KyThuatUAV/ESP32_FC/Tài liệu kèm theo/TAI_LIEU_TU_HOC.docx

KỸ THUẬT UAV

TÀI LIỆU TỰ HỌC

Phân tích hệ thống bộ điều khiển bay LacWing FC trên nền tảng ESP32

Tác giả: Nguyễn Văn Quý

Đối tượng phân tích: mã nguồn CODE_FC/LacWing_FC_level_1, bản phát hành 3f85e41

Quy mô: 1811 dòng trong 9 tệp nguồn

Trình biên dịch tham chiếu: Arduino ESP32 core 2.0.17, FQBN esp32:esp32:esp32da

Giấy phép: GNU General Public License phiên bản 3

Tháng 9 năm 2026

MỤC LỤC

# Danh mục mã nguồn

# Danh mục từ viết tắt

Viết tắt | Nguyên nghĩa | Diễn giải
DCM | Direction Cosine Matrix | ma trận cosin chỉ phương
DLPF | Digital Low-Pass Filter | bộ lọc thông thấp số bên trong cảm biến
ESC | Electronic Speed Controller | bộ điều tốc động cơ
FPU | Floating-Point Unit | khối tính số thực phần cứng
I²C | Inter-Integrated Circuit | bus nối tiếp hai dây
IIR | Infinite Impulse Response | bộ lọc đáp ứng xung vô hạn
IMU | Inertial Measurement Unit | cảm biến quán tính
ISA | International Standard Atmosphere | khí quyển tiêu chuẩn quốc tế
KF | Kalman Filter | bộ lọc Kalman
LEDC | LED Control | ngoại vi phát xung PWM của ESP32
LSB | Least Significant Bit | bước lượng tử nhỏ nhất của bộ biến đổi
ODR | Output Data Rate | tần số xuất dữ liệu của cảm biến
OSR | Oversampling Ratio | bội số lấy mẫu
PID | Proportional–Integral–Derivative | khối điều khiển tỉ lệ – tích phân – vi phân
PWM | Pulse-Width Modulation | điều chế độ rộng xung
QNH | — | áp suất khí quyển quy về mực nước biển
RC | Radio Control | điều khiển vô tuyến
RTOS | Real-Time Operating System | hệ điều hành thời gian thực
SBUS | Serial Bus | giao thức nối tiếp giữa bộ thu và bộ điều khiển bay
SMP | Symmetric Multiprocessing | đa xử lý đối xứng
SoC | System on Chip | hệ thống trên một chip
SPI | Serial Peripheral Interface | bus nối tiếp đồng bộ bốn dây
UART | Universal Asynchronous Receiver–Transmitter | cổng nối tiếp không đồng bộ

# Mở đầu: phạm vi, giả thiết và quy ước

## 0.1 Phạm vi

Tài liệu phân tích cấu trúc và đặc tính định lượng của phần mềm điều khiển bay cho phương tiện bay không người lái bốn cánh quạt cấu hình chữ X. Phân tích giới hạn ở lớp phần mềm nhúng; các vấn đề khí động lực học, mô hình hoá lực đẩy và nhận dạng tham số khung máy nằm ngoài phạm vi.

Đối tượng gồm chín tệp nguồn: tám tệp .ino, được trình dựng Arduino ghép thành một đơn vị biên dịch duy nhất, và một tệp tiêu đề types.h. Mỗi luận điểm trong tài liệu được gắn với đoạn mã hiện thực nó. Các đoạn mã then chốt được trích nguyên văn và phân tích theo từng dòng, để người đọc kiểm chứng trực tiếp trên mã nguồn thay vì tiếp nhận kết luận một cách thụ động.

## 0.2 Giả thiết

- G1. Cảm biến quán tính gắn cứng vào khung, trục cảm biến trùng trục thân máy, sai lệch lắp đặt được xem là nhỏ và đã bù bằng hằng số tĩnh.
- G2. Góc nghiêng vận hành nhỏ, cho phép xấp xỉ tuyến tính hoá quanh trạng thái treo.
- G3. Bốn cơ cấu chấp hành đồng nhất về đặc tính lực đẩy theo tín hiệu điều khiển; hệ không bù phi tuyến lực đẩy và không bù sụt áp nguồn.
- G4. Nhiễu đo của gia tốc kế và áp kế được mô hình hoá là nhiễu trắng Gauss không tương quan, kỳ vọng bằng không.

Giả thiết G4 bị vi phạm trong thực tế: nhiễu rung do cánh quạt là nhiễu có màu, tập trung phổ quanh tần số quay. Hệ quả được thảo luận ở §9.2.

## 0.3 Quy ước ký hiệu

Ký hiệu | Ý nghĩa | Đơn vị
Tₛ | chu kỳ lấy mẫu vòng điều khiển | s
φ, θ | góc nghiêng trục dọc (roll), trục ngang (pitch) | độ
p, q, r | vận tốc góc thân máy quanh ba trục | độ/s
a_x, a_y, a_z | gia tốc đo trong hệ thân máy | g
a_z^(E) | gia tốc thẳng đứng trong hệ mặt đất, đã trừ trọng trường | g
z, ż | độ cao và vận tốc thẳng đứng | cm, cm/s
(·)^(sp) | giá trị mong muốn (setpoint) | theo đại lượng
e, e0 | sai số của chu kỳ này và của chu kỳ liền trước | theo tầng
kp, ki, kd | hệ số khâu tỉ lệ, tích phân, vi phân | theo tầng
P_angle_roll, P_angle_pitch | đầu ra Tầng 2 (góc) — khối P | độ/s
PID_roll, PID_pitch, PID_yaw | đầu ra Tầng 1 (vận tốc góc) — khối PID | đơn vị đếm PWM
PID_vel_z | đầu ra Tầng 1 của trục thẳng đứng (vận tốc thẳng đứng) | đơn vị đếm PWM
throttle | ga lấy từ tay điều khiển | đơn vị đếm PWM

Đầu ra của mỗi khối điều khiển được đặt tên theo loại khối, không theo một tên chung cho mọi tín hiệu điều khiển: khối chỉ có khâu tỉ lệ cho đầu ra P_<tầng>, khối tỉ lệ – tích phân cho PI_<tầng>, khối đủ ba khâu cho PID_<tầng>. Riêng tầng vận tốc góc ghi theo trục (PID_roll, PID_pitch, PID_yaw) để khớp trực tiếp với công thức phân phối động cơ ở §5.5.

Các tầng được đánh số từ vòng trong ra ngoài: với hai trục nghiêng, vận tốc góc là Tầng 1 và góc là Tầng 2; với trục thẳng đứng, vận tốc thẳng đứng là Tầng 1. Nhờ đó tên gọi phản ánh cấu trúc: đọc tên là biết khối loại gì và nối vào tầng nào.

Quy ước đặt tên trong mã nguồn mang đơn vị ngay trong định danh (_deg, _dps, _cm, _cms, _g), nhằm loại trừ nhóm lỗi sai đơn vị tại các điểm ghép nối giữa mô-đun. Điểm ghép nối áp kế – bộ lọc Kalman (mét sang xen-ti-mét) là ví dụ điển hình cho lớp lỗi này, và được phân tích cụ thể ở Mã nguồn 4.5.

## 0.4 Đối chiếu ký hiệu với mã nguồn

Mã nguồn bản phát hành đặt đầu ra bộ điều khiển là u_*, và dùng tiền tố tilt, climb cho tầng góc và tầng vận tốc thẳng đứng. Bảng dưới cho phép đọc song song tài liệu và mã nguồn.

Ký hiệu trong tài liệu | Định danh trong mã nguồn | Tệp
PID_roll, PID_pitch, PID_yaw | u_roll, u_pitch, u_yaw | control_task.ino
P_angle_roll, P_angle_pitch | giá trị trả về của pid_tilt_roll(), pid_tilt_pitch() | pid.ino
PID_vel_z | giá trị trả về của pid_climb() | pid.ino
throttle | u_throttle ở chế độ ANGLE | control_task.ino
e, e0, I | error, st.prev_error, st.integral | pid.ino
kp_rate_roll, ki_rate_roll, kd_rate_roll | KP_RATE_ROLL, KI_RATE_ROLL, KD_RATE_ROLL | khối cấu hình
I_max, out_max | I_LIM_*, U_LIM_* | khối cấu hình

## 0.5 Quy ước trình bày mã nguồn

Mọi đoạn mã được trích nguyên văn từ bản phát hành 3f85e41, giữ nguyên chú thích gốc. Cột bên trái là số dòng trong tệp nguồn; ký hiệu ⋮ đánh dấu phần lược bỏ. Mỗi đoạn mã mang số hiệu Mã nguồn X.Y theo chương, được liệt kê ở Danh mục mã nguồn, và phần phân tích ngay sau đó dẫn chiếu theo số dòng.

Khi mã nguồn được sửa đổi về sau, số dòng có thể lệch; nội dung phân tích vẫn giữ nguyên giá trị đối với phần mã tương ứng.

# Chương 1. Kiến trúc phần mềm thời gian thực

## 1.1 Phân rã tác vụ

Hệ thống được phân rã thành ba tác vụ FreeRTOS chạy trên hai nhân xử lý của SoC ESP32:

Tác vụ | Nhân | Chu kỳ | Ưu tiên | Kích thước ngăn xếp
control_task | 1 | 2 ms (500 Hz) | 5 | 8192 B
rc_task | 0 | 2 ms (500 Hz) | 4 | 3072 B
baro_task | 0 | 10 ms (100 Hz) | 2 | 4096 B

Nhân 1 được dành riêng cho vòng điều khiển. Quyết định này loại bỏ hoàn toàn tranh chấp CPU giữa vòng điều khiển và các tác vụ ngoại vi, đổi lấy việc không tận dụng hết năng lực tính toán của nhân đó. Với hệ có ràng buộc thời gian cứng, đây là đánh đổi hợp lý: độ tin cậy về định thời quan trọng hơn hiệu suất sử dụng tài nguyên.

Trình tự dựng hệ đa tác vụ nằm ở cuối hàm setup():

Mã nguồn 1.1 — Tạo cơ chế đồng bộ và ba tác vụ (LacWing_FC_level_1.ino, dòng 204–217)

204 │ mtx_rc = xSemaphoreCreateMutex();

205 │ mtx_baro = xSemaphoreCreateMutex();

206 │ mtx_tlm = xSemaphoreCreateMutex();

207 │

208 │ if (mtx_rc == NULL || mtx_baro == NULL || mtx_tlm == NULL) {

209 │ Serial.println("Loi: khong tao duoc Mutex!");

210 │ while (1) delay(1000);

211 │ }

212 │

213 │ xTaskCreatePinnedToCore(rc_task, "RC", 3072, NULL, 4, NULL, 0);

214 │ xTaskCreatePinnedToCore(baro_task, "BARO", 4096, NULL, 2, NULL, 0);

215 │ xTaskCreatePinnedToCore(control_task, "CTRL", 8192, NULL, 5, NULL, 1);

216 │

217 │ vTaskDelete(NULL); // xoá loopTask của Arduino, giải phóng stack của nó

Phân tích.

- Dòng 204–211. Ba mutex được tạo và kiểm tra trước khi bất kỳ tác vụ nào tồn tại. Trình tự này là điều kiện cần: một tác vụ chạy trước khi mutex được tạo sẽ gọi xSemaphoreTake() trên một con trỏ rỗng. Giá trị NULL chỉ xuất hiện khi vùng nhớ động cạn; hệ dừng lại thay vì tiếp tục với một cơ chế đồng bộ khiếm khuyết.
- Dòng 213–215. xTaskCreatePinnedToCore() ghim mỗi tác vụ vào một nhân cố định, xác định bởi tham số cuối. Bộ lập lịch SMP của ESP-IDF vì thế không di trú tác vụ giữa hai nhân, loại bỏ một nguồn biến thiên định thời. Trên ESP-IDF [4], tham số kích thước ngăn xếp tính bằng byte, khác FreeRTOS gốc tính bằng từ máy — nhầm lẫn giữa hai quy ước là nguồn tràn ngăn xếp phổ biến khi chuyển mã giữa hai nền tảng.
- Thứ tự thực thi thực tế. Hàm setup() chạy bên trong tác vụ loopTask của khung Arduino, ghim ở nhân 1 với ưu tiên 1. Ngay khi control_task (ưu tiên 5, cùng nhân 1) được tạo ở dòng 215, nó chiếm quyền nhân; dòng 217 chỉ được thực thi khi control_task nhả CPU lần đầu tại vTaskDelayUntil(). Nói cách khác, chu kỳ điều khiển đầu tiên bắt đầu trước khi setup() kết thúc — hợp lệ, vì mọi khởi tạo cảm biến và bộ lọc đã hoàn tất ở các dòng phía trên.
- Dòng 217. vTaskDelete(NULL) huỷ chính loopTask; ngăn xếp của nó được tác vụ nhàn rỗi thu hồi. Hàm loop() vì thế không bao giờ được gọi.

## 1.2 Cơ chế giữ nhịp

Cả ba tác vụ dùng vTaskDelayUntil() thay vì vTaskDelay(). Khác biệt có ý nghĩa: vTaskDelayUntil() tính thời điểm đánh thức từ mốc tuyệt đối của lần trước, nên sai số thực thi của một chu kỳ không tích luỹ sang chu kỳ sau. Với vTaskDelay(), chu kỳ thực tế sẽ là Tₛ + δᵢ với δᵢ là thời gian thực thi thân vòng lặp, và sai số cộng dồn không giới hạn.

Mã nguồn 1.2 — Khung giữ nhịp của vòng điều khiển (control_task.ino, dòng 69–75 và 166–169)

69 │ void control_task(void *parameter) {

70 │ TickType_t wake = xTaskGetTickCount();

71 │ for (;;) {

72 │ static uint32_t t_prev_us = 0;

73 │ uint32_t t_now_us = micros();

74 │ loop_period_us = t_now_us - t_prev_us;

75 │ t_prev_us = t_now_us;

⋮

166 │ telemetry_snapshot();

167 │ vTaskDelayUntil(&wake, pdMS_TO_TICKS(PERIOD_CTRL_MS));

168 │ }

169 │ }

Phân tích.

- Dòng 70 và 167. Mốc wake được lấy một lần trước vòng lặp. Mỗi lần gọi ở dòng 167, hệ điều hành cộng đúng một chu kỳ vào mốc rồi cho tác vụ ngủ tới thời điểm đó. Chu kỳ danh định vì thế không phụ thuộc thời gian thực thi thân vòng. Nếu thân vòng lỡ vượt quá 2 ms, mốc mới đã nằm trong quá khứ, hàm trả về ngay và hệ chạy bù cho tới khi đuổi kịp lịch — không có chu kỳ nào bị "mất" khỏi thang thời gian tuyệt đối.
- Tiền đề ngoài mã nguồn. pdMS_TO_TICKS(2) bằng 2 tick nhờ tần số tick 1000 Hz của cấu hình Arduino-ESP32. Hệ quả: chu kỳ là bội nguyên của 1 ms. Nếu tần số tick là 100 Hz, macro trả về 0, vòng lặp chạy không giới hạn nhịp, và giả định Tₛ = DT_CTRL = 0,002 s — nền tảng của mọi phép tích phân và vi phân trong hệ — trở thành sai. Tính đúng của toàn bộ luật điều khiển phụ thuộc vào một tham số cấu hình của hệ điều hành nằm ngoài mã nguồn.
- Dòng 72–75. Chu kỳ thực được đo bằng micros(). Phép trừ trên kiểu uint32_t cho kết quả đúng cả khi bộ đếm tràn (sau khoảng 71,6 phút), nhờ số học đồng dư. Riêng lần lặp đầu tiên, mốc trước bằng 0 nên giá trị đo vô nghĩa — không ảnh hưởng điều khiển, vì biến này chỉ phục vụ quan sát qua cờ DEBUG_LOOP_TIME, với giá trị kỳ vọng 2000 µs.

## 1.3 Mô hình đồng bộ hoá và nhất quán dữ liệu

Dữ liệu chia sẻ giữa các tác vụ được bảo vệ bằng ba mutex độc lập, phân theo nhóm dữ liệu chứ không dùng một khoá toàn cục:

Mutex | Bảo vệ | Chiều ghi → đọc
mtx_rc | shared_rc_ch[17], shared_rc_ok | rc_task → control_task
mtx_baro | shared_baro_alt_m | baro_task → control_task
mtx_tlm | khối tlm_* | control_task → baro_task

Việc tách khoá theo nhóm loại bỏ phụ thuộc giả (false dependency) giữa các luồng dữ liệu không liên quan: tác vụ áp kế và tác vụ RC không bao giờ chặn lẫn nhau.

Chính sách lấy khoá. Mọi lời gọi xSemaphoreTake() đều dùng thời gian chờ bằng không. Nếu không lấy được khoá, tác vụ không chờ mà tiếp tục với dữ liệu của chu kỳ trước. Đây là quyết định thiết kế có chủ đích: vòng điều khiển không bao giờ được phép bị chặn. Cái giá là dữ liệu có thể cũ, nhưng độ cũ bị chặn trên bởi đúng một chu kỳ ghi (2 ms với RC, 10 ms với áp kế) — nhỏ hơn nhiều so với hằng số thời gian của mọi vòng điều khiển trong hệ.

Mô hình đệm kép. Tác vụ ghi chép dữ liệu vào vùng shared_* dưới khoá; tác vụ đọc sao chép sang biến cục bộ cũng dưới khoá, rồi thao tác trên bản sao. Nhờ đó mỗi chu kỳ điều khiển làm việc trên một ảnh chụp nhất quán về thời gian, thay vì đọc từng trường rời rạc có thể thuộc hai thời điểm khác nhau. Hai phía của kênh dữ liệu RC minh hoạ mô hình này.

Mã nguồn 1.3 — Phía ghi: tác vụ giải mã tay điều khiển (LacWing_FC_level_1.ino, dòng 228–240)

228 │ void rc_task(void *parameter) {

229 │ TickType_t wake = xTaskGetTickCount();

230 │ for (;;) {

231 │ bool ok = rc_update();

232 │

233 │ if (xSemaphoreTake(mtx_rc, 0) == pdTRUE) {

234 │ shared_rc_ok = ok;

235 │ for (int i = 1; i <= 16; i++) shared_rc_ch[i] = rc_get_channel(i);

236 │ xSemaphoreGive(mtx_rc);

237 │ }

238 │ vTaskDelayUntil(&wake, pdMS_TO_TICKS(PERIOD_RC_MS));

239 │ }

240 │ }

Mã nguồn 1.4 — Phía đọc: vòng điều khiển lấy dữ liệu tay điều khiển (control_task.ino, dòng 222–228)

222 │ void rc_fetch_and_map() {

223 │ if (xSemaphoreTake(mtx_rc, 0) == pdTRUE) {

224 │ rc_ok = shared_rc_ok;

225 │ for (int i = 1; i <= 16; i++) rc_ch[i] = shared_rc_ch[i];

226 │ xSemaphoreGive(mtx_rc);

227 │ }

228 │ for (int i = 5; i <= 8; i++) rc_ch[i] = rc_switch_position(rc_ch[i]);

Phân tích.

- Mã nguồn 1.3, dòng 231. Việc giải mã khung SBUS (§7.2) nằm ngoài vùng khoá. Vùng găng ở dòng 233–237 chỉ gồm việc sao chép mười sáu số nguyên và một cờ, nên thời gian giữ khoá vào cỡ micro giây, tối thiểu hoá xác suất tranh chấp.
- Mã nguồn 1.4, dòng 223–227. Phía đọc dùng cùng khuôn mẫu. rc_ok và mảng kênh được sao chép trong cùng một vùng khoá, nên không bao giờ xảy ra trạng thái lai "cờ của khung mới, kênh của khung cũ". Khi không lấy được khoá, cả hai cùng giữ giá trị cũ — cũ, nhưng vẫn nhất quán với nhau.
- Không có đảo ưu tiên. Hiện tượng đảo ưu tiên chỉ phát sinh khi tác vụ ưu tiên cao phải chờ tài nguyên do tác vụ ưu tiên thấp giữ. Thời gian chờ bằng không loại bỏ chính tiền đề đó; cơ chế thừa kế ưu tiên của mutex FreeRTOS vì vậy không bao giờ cần kích hoạt.
- Mã nguồn 1.4, dòng 228 — khiếm khuyết. Hàm rc_switch_position() biến đổi tại chỗ các kênh 5–8 từ độ rộng xung (1000–2000) sang số nấc công tắc (0, 1, 2), và được gọi vô điều kiện — kể cả khi dòng 223 không lấy được khoá. Trong trường hợp đó, rc_ch[5..8] vẫn chứa số nấc của chu kỳ trước và bị ánh xạ lần thứ hai. Vì các giá trị 0, 1, 2 không thuộc dải nào của hàm ánh xạ (control_task.ino, dòng 216–219), kết quả luôn là 0.

Hệ quả với công tắc arm đang ở nấc 2: một lần tranh chấp khoá làm rc_ch[CH_ARM] mang giá trị 0; điều kiện ở dòng 108 (Mã nguồn 8.1) lập tức đặt armed = false, và dòng 163 ghi đè bốn đầu ra bằng ESC_IDLE — động cơ ngừng khi đang bay. Chu kỳ kế tiếp, dù đọc lại được nấc 2, cũng không arm lại được, vì điều kiện arm đòi cần ga ở đáy. Kênh chế độ chịu cùng hiệu ứng: nấc 2 (ALT HOLD) bị đọc thành nấc 0 (ANGLE) trong một chu kỳ.

Hai tác vụ cùng thức theo lưới tick 1 ms, nên độ lệch pha giữa chúng được xác lập từ lúc khởi động. Khi hai tác vụ cùng pha, xác suất tranh chấp ở mỗi chu kỳ nhỏ nhưng khác không; với 500 lần thử mỗi giây và hệ quả là mất động lực trên không, khiếm khuyết không thể được biện minh bằng xác suất thấp.

Về bản chất, đây là lỗi thuộc lớp phép biến đổi không lũy đẳng áp lên trạng thái được giữ lại: f(f(x)) ≠ f(x). Nhánh "giữ giá trị cũ" của chính sách không chờ chỉ an toàn khi mọi xử lý phía sau là lũy đẳng trên dữ liệu cũ. Cách khắc phục: chỉ ánh xạ khi vừa sao chép dữ liệu mới — đưa dòng 228 vào trong khối điều kiện của dòng 223 — hoặc ánh xạ sang một mảng riêng thay vì ghi đè tại chỗ. Khiếm khuyết được ghi nhận là L9 ở Chương 10.

Khối telemetry đi theo chiều ngược lại và áp dụng cùng nguyên tắc: vòng điều khiển chỉ chụp trạng thái vào tlm_*; toàn bộ chi phí định dạng và truyền chuỗi do baro_task ở nhân 0 gánh. Không có lệnh xuất Serial nào nằm trong đường điều khiển. Đây là ràng buộc kiến trúc, không phải quy ước phong cách: ở 500 Hz, một lời gọi Serial.print() bị chặn do đầy bộ đệm truyền sẽ kéo dài chu kỳ và làm sai lệch mọi phép tích phân, vi phân dùng Tₛ hằng số.

## 1.4 Phân tích khả thi lịch biểu

Xét nhân 0 mang hai tác vụ. Đặt Cᵢ là thời gian thực thi xấu nhất, Tᵢ là chu kỳ. Tiêu chuẩn Liu–Layland [6] cho lịch biểu ưu tiên đơn điệu theo tần số với n tác vụ:

U = Σ_i=1^(n) Cᵢ/Tᵢ ≤ n(2^(1/n) - 1)

Với n = 2, ngưỡng là 0,828. Ước lượng thành phần:

- rc_task: đọc bộ đệm UART và giải mã tối đa 25 byte, C ≲ 60 µs trên T = 2 ms, đóng góp U ≈ 0,030.
- baro_task: một giao dịch I²C 7 byte ở 400 kHz chiếm khoảng 175 µs kể cả điều kiện khởi động và địa chỉ; cộng phần bù nhiệt – áp dùng số thực độ chính xác kép, ước tính C ≲ 400 µs trên T = 10 ms, đóng góp U ≈ 0,040.

Tổng U ≈ 0,07, thấp hơn ngưỡng một bậc độ lớn. Nhân 0 còn dư năng lực đáng kể; đây là chỗ có thể tiếp nhận thêm cảm biến mà không cần tái thiết kế.

Nhân 1 chỉ có một tác vụ nên điều kiện khả thi rút gọn thành C ≤ T. Ước lượng thành phần chi phối ở §9.1.

# Chương 2. Phân hệ cảm biến quán tính

## 2.1 Giao tiếp và cấu hình

Cảm biến ICM-20602 giao tiếp qua SPI ở 10 MHz, chế độ 0, truy cập trực tiếp thanh ghi. Không sử dụng thư viện trung gian. Quyết định này loại bỏ phụ thuộc phiên bản thư viện và cho phép kiểm soát chính xác trình tự khởi tạo, nhưng chuyển gánh nặng đúng đắn sang người viết.

Thanh ghi | Giá trị | Ý nghĩa
PWR_MGMT_1 (0x6B) | 0x00 | thoát chế độ ngủ
ACCEL_CONFIG (0x1C) | 0x18 | thang đo gia tốc ±16 g
GYRO_CONFIG (0x1B) | 0x18 | thang đo con quay ±2000 °/s
CONFIG (0x1A) | 0x06 | DLPF con quay: dải thông 3 dB 5 Hz, dải thông nhiễu 8 Hz, xuất dữ liệu 1 kHz
ACCEL_CONFIG2 (0x1D) | 0x05 | DLPF gia tốc kế: dải thông 3 dB 10,2 Hz, xuất dữ liệu 1 kHz

Các giá trị dải thông lấy theo bảng cấu hình bộ lọc trong datasheet ICM-20602 [1], mục 9.16 và 9.19. Cần lưu ý rằng ở cả hai cấu hình, cảm biến chỉ cập nhật thanh ghi dữ liệu 1000 lần mỗi giây; con số này chi phối cách hiểu thuật toán hiệu chỉnh ở §2.3.

Tính hiện diện của cảm biến được kiểm chứng qua thanh ghi WHO_AM_I (0x75) với giá trị kỳ vọng 0x12, trước khi thực hiện hiệu chỉnh. Trình tự này là bắt buộc: nếu cảm biến không phản hồi, bus SPI trả về giá trị hằng, hai lô mẫu liên tiếp trong vòng hiệu chỉnh sẽ giống hệt nhau, và điều kiện hội tụ được thoả mãn một cách sai lầm với độ lệch vô nghĩa. Khi không phát hiện được cảm biến, hệ thống dừng vô hạn và nhấp nháy đèn báo thay vì tiếp tục khởi động.

Toàn bộ số liệu quán tính đi qua hai hàm đọc gộp có cấu trúc giống hệt nhau; hàm đọc gia tốc được trích dưới đây.

Mã nguồn 2.1 — Đọc gộp ba trục gia tốc qua SPI (imu_icm20602.ino, dòng 300–309)

300 │ void imu_read_accel_raw(int16_t &x, int16_t &y, int16_t &z) {

301 │ digitalWrite(PIN_IMU_CS, LOW);

302 │ SPI.beginTransaction(imu_spi);

303 │ SPI.transfer(REG_ACCEL_XOUT_H | 0x80);

304 │ x = (SPI.transfer(0x00) << 8) | SPI.transfer(0x00);

305 │ y = (SPI.transfer(0x00) << 8) | SPI.transfer(0x00);

306 │ z = (SPI.transfer(0x00) << 8) | SPI.transfer(0x00);

307 │ SPI.endTransaction();

308 │ digitalWrite(PIN_IMU_CS, HIGH);

309 │ }

Phân tích.

- Dòng 301–302 và 307–308. Khung giao dịch: hạ chân chọn chip, mở giao dịch với cấu hình riêng của cảm biến (10 MHz, chế độ 0), rồi đóng theo thứ tự ngược lại. beginTransaction() đồng thời khoá bus, để không tác vụ nào chen vào giữa một giao dịch.
- Dòng 303. Bit 7 của byte địa chỉ bằng 1 báo phép đọc. Sau byte địa chỉ, ICM-20602 tự tăng địa chỉ thanh ghi, nên sáu byte liên tiếp ở dòng 304–306 là X, Y, Z của gia tốc. Đọc gộp trong một giao dịch bảo đảm ba trục thuộc cùng một thời điểm lấy mẫu.
- Dòng 304–306, thứ tự đánh giá. Mỗi trục là số bù hai 16 bit, byte cao trước. Biểu thức (SPI.transfer(0x00) << 8) | SPI.transfer(0x00) ghép byte cao với byte thấp. Theo chuẩn C++ [7], hai toán hạng của phép | không được sắp thứ tự với nhau: hai lời gọi hàm chỉ được bảo đảm không đan xen, còn lời gọi nào chạy trước là không xác định (unspecified). Mã chạy đúng vì trình biên dịch GCC của nền tảng đánh giá toán hạng trái trước — điều mà việc bay được đã gián tiếp xác nhận — nhưng tính đúng không được ngôn ngữ bảo đảm. Một trình biên dịch khác, hoặc một mức tối ưu khác, có quyền đảo hai byte mà không phát sinh cảnh báo nào. Cách viết an toàn là đọc hai byte vào hai biến tạm theo thứ tự tường minh rồi mới ghép. Ghi nhận là L11.
- Dòng 304–306, chuyển kiểu. Kết quả phép | là số nguyên không âm trong khoảng 0–65535. Gán giá trị lớn hơn 32767 vào int16_t là chuyển đổi do cài đặt quy định trước C++20 (GCC định nghĩa theo đồng dư 2^(16)), và được chuẩn hoá thành đồng dư từ C++20. Nhờ đó giá trị bù hai được khôi phục đúng.

## 2.2 Lượng tử hoá

Bộ biến đổi 16 bit trên hai thang đo đã chọn cho độ phân giải:

Δ_ω = 1/(16,4) ≈ 6,10 × 10⁻² °/s, Δₐ = 1/2048 ≈ 4,88 × 10⁻⁴ g

Sai số lượng tử hoá gia tốc kế truyền sang góc suy ra từ gia tốc. Tuyến tính hoá quanh trạng thái nằm ngang, với φ = arctan(a_y/√(a_x²+a_z²)):

(∂ φ)/(∂ a_y)|_φ=0 = 1 rad/g ⟹ δφ ≈ Δₐ · 180/π ≈ 0,028°

Độ phân giải góc do lượng tử hoá là 0,028°, nhỏ hơn hai bậc so với nhiễu rung cơ khí trong điều kiện bay thực. Kết luận: lượng tử hoá không phải là nguồn sai số chi phối; việc chọn thang đo rộng (±16 g, ±2000 °/s) để tránh bão hoà là đánh đổi đúng.

## 2.3 Hiệu chỉnh độ lệch con quay

Thuật toán hiệu chỉnh không lấy trung bình một lô cố định rồi chấp nhận kết quả. Thay vào đó nó lặp cho tới khi phát hiện phương tiện thực sự đứng yên:

Lô thứ k: Sₖ = Σ_i=1^(N) ωᵢ, N = 500

Điều kiện dừng, áp đồng thời cho ba trục:

|Sₖ - S_k-1| < Λ, Λ = 40

Chuyển ngưỡng về đơn vị vật lý: Λ/N = 40/500 = 0,08 °/s là chênh lệch trung bình cho phép giữa hai lô liên tiếp. Ngưỡng này độc lập với thang đo vì Sₖ được tích luỹ sau khi đã quy đổi sang °/s.

Mã nguồn 2.2 — Hiệu chỉnh độ lệch con quay có kiểm tra hội tụ (imu_icm20602.ino, dòng 187–222)

187 │ void imu_calibrate_gyro() {

188 │ const int SAMPLES = 500;

189 │ const float STABLE_LIMIT = 40.0f; // ngưỡng lệch giữa hai đợt liên tiếp

190 │

191 │ float sum_roll = 0, sum_pitch = 0, sum_yaw = 0;

192 │ float prev_roll = 0, prev_pitch = 0, prev_yaw = 0;

193 │

194 │ Serial.println("bat dau hieu chinh gyro");

195 │

196 │ while (1) {

197 │ prev_roll = sum_roll; prev_pitch = sum_pitch; prev_yaw = sum_yaw;

198 │ sum_roll = 0; sum_pitch = 0; sum_yaw = 0;

199 │

200 │ digitalWrite(PIN_IMU_LED, HIGH);

201 │ for (int i = 0; i < SAMPLES; i++) {

202 │ imu_read_raw();

203 │ sum_roll += imu_rate_roll_dps;

204 │ sum_pitch += imu_rate_pitch_dps;

205 │ sum_yaw += imu_rate_yaw_dps;

206 │ delayMicroseconds(10);

207 │ }

208 │

209 │ Serial.println("Dang hieu chinh gyro - Khong di chuyen Drone!");

210 │

211 │ if (fabsf(sum_roll - prev_roll) < STABLE_LIMIT &&

212 │ fabsf(sum_pitch - prev_pitch) < STABLE_LIMIT &&

213 │ fabsf(sum_yaw - prev_yaw) < STABLE_LIMIT) {

214 │ Serial.println("cali gyro thanh cong");

215 │ digitalWrite(PIN_IMU_LED, LOW);

216 │ break;

217 │ }

218 │ }

219 │

220 │ gyro_bias_roll_dps = sum_roll / SAMPLES;

221 │ gyro_bias_pitch_dps = sum_pitch / SAMPLES;

222 │ gyro_bias_yaw_dps = sum_yaw / SAMPLES;

Phân tích.

- Dòng 197–198. Tổng của lô trước được lưu làm mốc so sánh trước khi tích luỹ lô mới. Ở lần lặp đầu, mốc bằng 0, nên điều kiện dừng chỉ thoả khi bản thân tổng đã nhỏ hơn 40 — tức độ lệch trung bình dưới 0,08 °/s, trường hợp mà kết quả vẫn đúng. Trong trường hợp thông thường, thuật toán cần tối thiểu hai lô.
- Dòng 201–207 — số lần đọc và số mẫu độc lập. Mỗi lần đọc gồm hai giao dịch SPI cộng 10 µs chờ, nên một lô 500 lần đọc kéo dài cỡ 20 ms. Cần phân biệt số lần đọc với số mẫu độc lập. Cảm biến chỉ cập nhật thanh ghi 1000 lần mỗi giây (§2.1), nên một lô chứa khoảng 20 giá trị khác nhau; các giá trị này lại tương quan mạnh do DLPF. Với tín hiệu có dải thông nhiễu Bₙ = 8 Hz, số mẫu độc lập trong khoảng thời gian T xấp xỉ 2 Bₙ T = 2 × 8 × 0,02 ≈ 0,3 — ít hơn một. Tác dụng giảm nhiễu vì thế thực chất đến từ bộ lọc DLPF, không đến từ N = 500; con số 500 nên được hiểu là độ dài cửa sổ quan sát chứ không phải cỡ mẫu thống kê.
- Dòng 211–213 — bản chất của điều kiện dừng. Điều kiện so sánh hai cửa sổ liền kề, mỗi cửa sổ khoảng 20 ms. Về bản chất, đây là bộ phát hiện biến thiên của vận tốc góc giữa hai cửa sổ, không phải bộ phát hiện chuyển động: một phép quay đều sinh ra hai tổng xấp xỉ nhau, vượt qua kiểm tra, và để lại độ lệch ước lượng bằng đúng vận tốc quay đó. Ngưỡng 0,08 °/s trên khoảng cách 20 ms tương ứng gia tốc góc cỡ 4 °/s². Chuyển động của tay người có gia tốc góc lớn hơn nhiều bậc, nên kịch bản cần bảo vệ — cấp nguồn khi tay còn cầm hoặc khung còn đang bị chạm — được phát hiện đúng. Kịch bản không được bảo vệ, quay đều liên tục trong lúc hiệu chỉnh, không có ý nghĩa thực tế với phương tiện đặt trên mặt đất.
- Dòng 220–222. Độ lệch là trung bình của lô cuối cùng — lô vừa vượt qua kiểm tra.

Lập luận về tính đúng đắn. Phương pháp lô đơn có lỗ hổng: nếu phương tiện đang chuyển động trong lúc lấy mẫu, chuyển động đó bị hấp thụ vào ước lượng độ lệch. Độ lệch sai làm bộ điều khiển hiểu nhầm phương tiện đang quay khi nó đứng yên, sinh ra mô-men hiệu chỉnh thường trực và gây trôi ngay từ thời điểm cất cánh. Điều kiện dừng dựa trên tính lặp lại giữa hai lô phát hiện được tình huống này, vì chuyển động ngẫu nhiên không cho hai tổng liên tiếp gần nhau.

Cái giá là thời gian hiệu chỉnh không xác định trước. Trong bối cảnh khởi động mặt đất, đây là đánh đổi chấp nhận được.

## 2.4 Bù độ lệch gia tốc kế

Ba hằng số ACC_OFFSET_*_G được cộng vào số đo thô. Quy trình xác định chúng được thực hiện bởi khối imu_calibrate_accel(), biên dịch có điều kiện qua CALIBRATE_ACCEL, lấy trung bình 2000 mẫu ở tư thế nằm ngang và in ra trực tiếp ba dòng khai báo cần dán vào mã nguồn.

Chế độ này có hai kiểm tra tư thế trước khi tin kết quả: a_z ≥ 0,80 g loại trừ trường hợp lật ngược hoặc dựng nghiêng, và | a_x|, | a_y| ≤ 0,30 g loại trừ mặt phẳng đặt không ngang hoặc cảm biến gắn lệch. Trường hợp thứ hai cần sửa cơ khí, không được bù bằng phần mềm.

Sau khi đo xong, hàm không trả về mà dừng vô hạn. Hệ quả là các tác vụ điều khiển không bao giờ được tạo, nên không thể bay ở chế độ hiệu chỉnh. Điều này quan sát được qua kích thước ảnh nhị phân: bản có CALIBRATE_ACCEL chiếm 21% bộ nhớ chương trình so với 23% của bản thường, do trình tối ưu loại bỏ được toàn bộ nhánh không tới được.

# Chương 3. Phân hệ áp kế

## 3.1 Ràng buộc định thời giữa ODR và OSR

BMP388 được cấu hình qua thanh ghi, không dùng thư viện. Thời gian chuyển đổi điển hình của một chu kỳ đo theo datasheet Bosch [2], mục 3.9.2:

T_conv = 234 + (392 + 2^(osr_p) · 2000) + (313 + 2^(osr_t) · 2000) [µs]

Với cấu hình đang dùng, osr_p = 3 (bội 8) và osr_t = 0 (bội 1):

T_conv = 234 + 16392 + 2313 = 18939 µs ≈ 18,94 ms

Chu kỳ ở ODR 50 Hz là 20 ms, biên điển hình 1,06 ms, tương đương 5,3%. Tuy nhiên datasheet còn công bố giá trị tối đa: với cặp bội lấy mẫu này, Bảng 22 (mục 3.9.1) cho thời gian đo điển hình 18,69 ms và tối đa 21,53 ms, tức tần số đo tối thiểu 46,4 Hz. Nói cách khác, ODR 50 Hz được bảo đảm ở điều kiện điển hình nhưng không được bảo đảm ở biên sai lệch linh kiện.

Hai lập luận cho thấy lựa chọn này vẫn đúng:

1. Đây chính là cấu hình Bosch khuyến nghị cho ứng dụng drone ở Bảng 10 (mục 3.5): chế độ thường, bội lấy mẫu áp suất ×8 và nhiệt độ ×1, ODR 50 Hz, nhiễu RMS khoảng 11 cm.
2. Kiến trúc phía sau chịu được việc tần số đo thực tụt xuống. Cổng dữ liệu theo cờ sẵn sàng (§3.2) bảo đảm không mẫu nào bị đọc trùng, còn bộ lọc độ cao dùng giá trị mới nhất ở mỗi chu kỳ (§4.4). Nếu tần số đo thực là 46,4 Hz thay vì 50 Hz, độ cũ của phép đo tăng từ 20 ms lên tối đa 21,5 ms — không đáng kể so với hằng số thời gian τ_z ≈ 1,94 s của vòng ước lượng độ cao.

Nếu tăng ODR mà giữ nguyên OSR, cảm biến tự báo lỗi conf_err ở bit 2 thanh ghi ERR_REG (mục 4.3.2); mã nguồn kiểm tra và báo lỗi này tường minh khi khởi tạo.

Mã nguồn 3.1 — Cấu hình BMP388 và kiểm tra lỗi cấu hình (baro_bmp388.ino, dòng 258–278)

258 │ static bool baro_configure() {

259 │ if (!baro_write_reg(BMP388_REG_PWR_CTRL, 0x00)) return false; // về sleep

260 │ delay(2);

261 │

262 │ uint8_t osr = (uint8_t)((BARO_OSR_TEMP << 3) | BARO_OSR_PRESS);

263 │ if (!baro_write_reg(BMP388_REG_OSR, osr)) return false;

264 │ if (!baro_write_reg(BMP388_REG_ODR, BARO_ODR_SETTING)) return false;

265 │ if (!baro_write_reg(BMP388_REG_CONFIG, (uint8_t)(BARO_IIR_SETTING << 1))) return false;

266 │

267 │ uint8_t pwr = (uint8_t)(BMP388_PRESS_EN | BMP388_TEMP_EN | BMP388_MODE_NORMAL);

268 │ if (!baro_write_reg(BMP388_REG_PWR_CTRL, pwr)) return false;

269 │ delay(5);

270 │

271 │ uint8_t err = 0;

272 │ if (!baro_read_reg(BMP388_REG_ERR, err)) return false;

273 │ if (err & 0x01) { Serial.println("BMP388 fatal_err"); return false; }

274 │ if (err & 0x02) { Serial.println("BMP388 cmd_err"); return false; }

275 │ if (err & 0x04) { Serial.println("BMP388 conf_err - OSR khong khop ODR"); return false; }

276 │

277 │ return true;

278 │ }

Phân tích.

- Dòng 259–260. Đưa cảm biến về trạng thái ngủ trước khi ghi cấu hình, để các thanh ghi được nạp khi không có chu kỳ đo nào đang dở dang.
- Dòng 262. Thanh ghi OSR gộp hai trường: bội lấy mẫu nhiệt độ ở bit [5:3], áp suất ở bit [2:0]. Dòng 265: hệ số bộ lọc IIR nằm ở bit [3:1] của thanh ghi CONFIG, nên được dịch trái một bit.
- Dòng 267–268. Bật đồng thời phép đo áp suất, nhiệt độ và chế độ thường — chế độ cảm biến tự đo theo chu kỳ ODR, không cần lệnh kích từ phía vi điều khiển.
- Dòng 271–275. Đọc ERR_REG ngay sau khi vào chế độ thường; ba bit lỗi được xử lý riêng, trong đó conf_err là hệ quả trực tiếp của ràng buộc ODR – OSR ở trên. Các cờ lỗi tự xoá khi đọc (mục 4.3.2), nên phép đọc này vừa kiểm tra vừa đặt lại trạng thái lỗi.

Lựa chọn OSR bội 8 thay vì bội 1 đánh đổi tốc độ lấy nhiều mẫu để giảm nhiễu áp suất. Với ứng dụng giữ độ cao, nhiễu áp suất là đại lượng chi phối chất lượng điều khiển, còn 50 Hz đã dư so với băng thông vòng độ cao (§5.4).

## 3.2 Cổng dữ liệu theo cờ sẵn sàng

baro_task chạy ở 100 Hz trong khi cảm biến chỉ sinh mẫu ở 50 Hz. Hàm baro_update() đọc gộp thanh ghi STATUS (0x03) cùng sáu byte dữ liệu (0x04–0x09) trong một giao dịch I²C, và chỉ chấp nhận số liệu khi bit drdy_press được đặt.

Bỏ qua kiểm tra này gây hệ quả tinh vi: cùng một mẫu bị đọc hai lần và nạp vào bộ lọc Kalman như hai phép đo độc lập. Bộ lọc khi đó thu hẹp hiệp phương sai sai số ước lượng nhanh gấp đôi mức chính đáng — nghĩa là nó trở nên tự tin sai cách, và bám nhiễu áp kế thay vì lọc nhiễu. Lỗi thuộc loại không sinh triệu chứng rõ ràng và rất khó truy ngược từ hiện tượng bay.

Mã nguồn 3.2 — Đọc một mẫu áp kế có cổng cờ sẵn sàng (baro_bmp388.ino, dòng 291–310)

291 │ bool baro_update() {

292 │ if (!baro_ready) return false;

293 │

294 │ uint8_t buf[7];

295 │ if (!baro_read_regs(BMP388_REG_STATUS, buf, 7)) return false;

296 │ if (!(buf[0] & BMP388_STATUS_DRDY_PRESS)) return false;

297 │

298 │ const uint8_t *data = &buf[1];

299 │ uint32_t raw_press = u24le(&data[0]);

300 │ uint32_t raw_temp = u24le(&data[3]);

301 │ if (raw_press == 0 && raw_temp == 0) return false;

302 │

303 │ double temp_c = baro_compensate_temp(raw_temp);

304 │ double press_pa = baro_compensate_press(raw_press, temp_c);

305 │

306 │ baro_temp_c = (float)temp_c;

307 │ baro_press_pa = (float)press_pa;

308 │ baro_alt_abs_m = (float)baro_press_to_altitude_m(press_pa);

309 │ return true;

310 │ }

Phân tích.

- Dòng 295. Bảy byte được đọc bắt đầu từ STATUS (0x03). Thanh ghi trạng thái nằm ngay trước khối dữ liệu 0x04–0x09, nên cờ và dữ liệu thuộc cùng một giao dịch. Datasheet khuyến nghị đọc gộp để tránh ghép lẫn byte của hai phép đo khác nhau (mục 3.10), và cảm biến dùng cơ chế thanh ghi bóng để giữ ổn định khối dữ liệu trong suốt một lượt đọc gộp (mục 3.10.1).
- Dòng 296. Cờ drdy_press được cảm biến tự xoá khi thanh ghi dữ liệu áp suất được đọc (mục 4.3.3). Vì vậy lần gọi kế tiếp, 10 ms sau, chắc chắn thấy cờ bằng 0 nếu chưa có mẫu mới. Cơ chế loại bỏ mẫu trùng không cần bất kỳ trạng thái nào ở phía phần mềm — trạng thái nằm trong cảm biến.
- Dòng 299–301. Áp suất và nhiệt độ là số không dấu 24 bit, byte thấp trước. Khung toàn 0 bị loại như dấu hiệu của một giao dịch hỏng.
- Dòng 303–308. Bù nhiệt trước, dùng nhiệt độ đã bù để bù áp suất — vì đa thức bù áp suất phụ thuộc nhiệt độ — rồi mới quy đổi sang độ cao (§3.3).

Khác biệt giữa hai giao diện số. Ở giao diện SPI, BMP388 chèn một byte giả ngay sau byte điều khiển trước khi xuất dữ liệu (datasheet, mục 5.3.2); ở giao diện I²C thì không. Hàm đọc mức thấp của bản này vì thế đọc thẳng dữ liệu. Chuyển nguyên văn hàm đọc từ một cài đặt SPI sang I²C sẽ làm mọi byte lệch một vị trí — một lỗi không sinh mã lỗi nào, chỉ sinh số liệu sai.

## 3.3 Bù nhiệt – áp và quy đổi độ cao

Hai mươi mốt byte hệ số hiệu chỉnh riêng của từng chip được đọc từ thanh ghi CALIB (0x31) và giải mã theo đúng thang chia của datasheet (mục 3.11). Đa thức bù theo công thức tham chiếu ở mục 9.2 và 9.3, được tính bằng số thực độ chính xác kép: các hệ số P_9, P_10, P_11 có thang chia tới 2^(48) và 2^(65), vượt quá dải biểu diễn hữu ích của số thực độ chính xác đơn.

Quy đổi áp suất sang độ cao dùng công thức khí quyển tiêu chuẩn:

h = 44330 [1 - (p/p₀)^(0,1902949571836346)] [m], p₀ = 101325 Pa

Số mũ là R L / (g M) của mô hình ISA tầng đối lưu. Độ cao tuyệt đối này chỉ đúng khi áp suất mực nước biển thực tế bằng p₀; hệ thống không hiệu chỉnh theo QNH. Điều đó không ảnh hưởng chức năng vì đại lượng dùng cho điều khiển là độ cao tương đối so với mốc đo lúc khởi động:

h_rel = h - h_ref

với h_ref lấy trung bình 50 mẫu hợp lệ trong baro_measure_reference(). Sai số hệ thống do p₀ sai bị triệt tiêu trong phép trừ.

# Chương 4. Ước lượng trạng thái

## 4.1 Ước lượng góc nghiêng — bộ lọc Kalman vô hướng

Cấu trúc bộ lọc tham khảo từ tài liệu của Carbon Aeronautics [10]. Với mỗi trục nghiêng, mô hình trạng thái một chiều:

φₖ⁻ = φ_k-1⁺ + Tₛ ωₖ, Pₖ⁻ = P_k-1⁺ + Tₛ² σ_w²

Kₖ = Pₖ⁻/(Pₖ⁻ + σ_v²), φₖ⁺ = φₖ⁻ + Kₖ(φₖ^(acc) - φₖ⁻), Pₖ⁺ = (1 - Kₖ) Pₖ⁻

Tham số đang dùng: σ_w = 1 °/s (nhiễu quá trình, tức độ bất định của vận tốc góc), σ_v = 3° (nhiễu đo của góc suy từ gia tốc kế), Tₛ = 0,002 s.

Mã nguồn 4.1 — Một bước lọc Kalman vô hướng cho góc nghiêng (imu_icm20602.ino, dòng 267–277)

267 │ // Kalman 1 chiều: gyro là đầu vào dự đoán, góc từ gia tốc kế là phép đo.

268 │ // var_process = 1 (độ/giây)^2, var_measure = 3^2 độ^2.

269 │ void imu_kalman_1d(float &state_deg, float &variance,

270 │ float rate_dps, float measure_deg) {

271 │ state_deg += DT_CTRL * rate_dps;

272 │ variance += DT_CTRL * DT_CTRL * 1.0f * 1.0f;

273 │

274 │ float gain = variance / (variance + 3.0f * 3.0f);

275 │ state_deg += gain * (measure_deg - state_deg);

276 │ variance = (1.0f - gain) * variance;

277 │ }

Phân tích. Năm dòng thân hàm ánh xạ một – một với năm phương trình:

Dòng | Biểu thức trong mã | Phương trình
271 | state_deg += DT_CTRL * rate_dps | dự đoán trạng thái φ⁻ = φ⁺ + Tₛω
272 | variance += DT_CTRL * DT_CTRL * 1.0f * 1.0f | dự đoán phương sai P⁻ = P⁺ + Tₛ²σ_w²
274 | gain = variance / (variance + 3.0f * 3.0f) | độ lợi K = P⁻/(P⁻ + σ_v²)
275 | state_deg += gain * (measure_deg - state_deg) | hiệu chỉnh trạng thái
276 | variance = (1.0f - gain) * variance | hiệu chỉnh phương sai

Trạng thái và phương sai được truyền theo tham chiếu (dòng 269), nên cùng một hàm phục vụ cả hai trục mà không cần biến toàn cục riêng.

Nghiệm dừng. Đặt q = Tₛ²σ_w² = 4×10⁻⁶ và R = σ_v² = 9. Ở trạng thái dừng, P⁺ = P⁻ - q và phương trình Riccati rời rạc rút gọn thành

x² - qx - qR = 0, x ≡ P⁻

Vì q ≪ R, nghiệm dương xấp xỉ x ≈ √(qR), cho độ lợi dừng

K∞ ≈ √(q/R) = √((4×10⁻⁶)/9) ≈ 6,67×10⁻⁴

Diễn giải. Bộ lọc Kalman vô hướng với độ lợi dừng tương đương một bộ lọc bù (complementary filter) có hằng số thời gian

τ = Tₛ/K∞ ≈ (0,002)/(6,67×10⁻⁴) ≈ 3,0 s

Nghĩa là: thành phần góc từ gia tốc kế được hoà vào ước lượng với hằng số thời gian khoảng ba giây; trong khung thời gian ngắn hơn, ước lượng do con quay chi phối hoàn toàn. Đây là đặc tính mong muốn — gia tốc kế trong lúc cơ động đo cả gia tốc chuyển động lẫn trọng trường, nên góc suy ra từ nó chỉ đáng tin ở trung bình dài hạn.

Quá trình hội tụ. Phương sai khởi tạo P₀ = 4 độ² (att_roll_var, att_pitch_var, dòng 70–71 của cùng tệp). Khi P ≫ √(qR), nhiễu quá trình không đáng kể và phương trình cập nhật viết lại được theo nghịch đảo phương sai:

1/Pₖ⁺ ≈ 1/P₀ + k/R ⟹ Kₖ ≈ 1/(k + R/P₀)

Độ lợi giảm theo 1/k: trong giai đoạn này bộ lọc tương đương trung bình cộng các góc suy từ gia tốc kế kể từ lúc khởi động — cách khởi tạo tối ưu khi trạng thái ban đầu chưa biết. Giai đoạn kết thúc khi 1/k giảm tới độ lợi dừng, tức sau số chu kỳ

k_c ≈ 1/K∞ = √(R/q) = 1500 (≈ 3 s)

Sau đó bộ lọc chuyển sang chế độ quên theo hàm mũ với hằng số thời gian 3 s. Hệ quả: phương tiện tự căn góc ban đầu mà không cần bước khởi tạo riêng, với điều kiện đứng yên trong vài giây đầu — điều kiện đã được bảo đảm bởi quy trình hiệu chỉnh con quay (§2.3) diễn ra ngay trước đó.

Phép đo của bộ lọc là góc suy ra từ gia tốc kế, tính mỗi lần đọc cảm biến:

Mã nguồn 4.2 — Góc nghiêng suy từ gia tốc kế (imu_icm20602.ino, dòng 256–263)

256 │ // Góc từ gia tốc kế, tính trên giá trị đã bù lệch.

257 │ // Roll chủ yếu từ acc_Y và acc_Z, pitch chủ yếu từ acc_X và acc_Z.

258 │ float ax = imu_acc_x_g + ACC_OFFSET_X_G;

259 │ float ay = imu_acc_y_g + ACC_OFFSET_Y_G;

260 │ float az = imu_acc_z_g + ACC_OFFSET_Z_G;

261 │

262 │ acc_roll_deg = atanf(ay / sqrtf(ax * ax + az * az)) * RAD_TO_DEG;

263 │ acc_pitch_deg = -atanf(ax / sqrtf(ay * ay + az * az)) * RAD_TO_DEG;

Phân tích.

- Dòng 258–260. Bù lệch được cộng trước khi tính góc, nên sai số hiệu chỉnh gia tốc kế truyền thẳng vào phép đo của bộ lọc — và qua đó vào góc cân bằng mà phương tiện tìm về.
- Dòng 262–263. Cả hai công thức dùng căn tổng bình phương của hai trục còn lại ở mẫu số. Dạng đối xứng này không ứng đúng với một thứ tự quay Euler duy nhất — với một thứ tự quay xác định, một trong hai góc sẽ có dạng arctan(a_y/a_z) [11] — nhưng trùng với các dạng chuẩn tới bậc nhất quanh trạng thái nằm ngang, phù hợp với giả thiết G2. Hàm atanf một đối số giới hạn kết quả trong (−90°, 90°): phép đo không biểu diễn được tư thế lộn ngược, điều cũng nằm ngoài giả thiết G2.
- Dòng 263. Dấu âm của góc pitch xác định chiều dương của trục. Dấu này nhất quán với số hạng -sinθ · a_x trong phép chiếu ở Mã nguồn 4.3 — kiểm chứng ở §4.2.

Hạn chế. Mô hình đo giả định gia tốc kế chỉ cảm nhận trọng trường (giả thiết G4 mở rộng). Trong cơ động kéo dài quá vài giây theo một hướng, giả định này sai và ước lượng góc lệch dần.

Sai lệch này không loại bỏ được trong khuôn khổ một bộ lọc vô hướng chỉ có hai nguồn tin là con quay và gia tốc kế. Lý do mang tính nguyên tắc: gia tốc kế đo tổng của trọng trường và gia tốc chuyển động, mà từ một phép đo tổng thì không tách được hai thành phần nếu không có thông tin độc lập về một trong hai. Việc chọn τ ≈ 3 s chỉ làm chậm quá trình lệch, không ngăn được nó.

## 4.2 Chiếu gia tốc về hệ quy chiếu mặt đất

Thành phần thẳng đứng của gia tốc trong hệ mặt đất, đã trừ trọng trường:

a_z^(E) = -sinθ · a_x + cosθ sinφ · a_y + cosθ cosφ · a_z - 1

Đây là hàng thứ ba của ma trận cosin chỉ phương từ hệ thân sang hệ mặt đất, áp lên véc-tơ gia tốc đo. Phép chiếu chỉ cần hai góc nghiêng, không cần góc hướng, vì trục thẳng đứng bất biến với phép quay quanh chính nó. Hệ quả thiết kế: bậc này không cần bộ lọc quaternion (Madgwick, Mahony) cũng như không cần từ kế.

Mã nguồn 4.3 — Chiếu gia tốc về phương thẳng đứng (control_task.ino, dòng 88–92)

88 │ // Gia tốc theo phương thẳng đứng của mặt đất, trừ đi 1g.

89 │ // Chỉ cần góc roll/pitch nên không phải dùng tới Madgwick hay Mahony.

90 │ float sr = sinf(roll_deg * DEG_TO_RAD), cr = cosf(roll_deg * DEG_TO_RAD);

91 │ float sp = sinf(pitch_deg * DEG_TO_RAD), cp = cosf(pitch_deg * DEG_TO_RAD);

92 │ acc_earth_z_g = -sp * acc_x_g + cp * sr * acc_y_g + cp * cr * acc_z_g - 1.0f;

Phân tích.

- Dòng 90–91. Bốn hàm lượng giác được tính một lần rồi dùng lại cho cả ba số hạng.
- Kiểm chứng tĩnh. Xét phương tiện đứng yên, nghiêng thuần theo trục ngang: a_y = 0 và a_x² + a_z² = 1. Từ Mã nguồn 4.2, sinθ = -a_x, cosθ = a_z và φ = 0; thay vào dòng 92 được a_z^(E) = a_x² + a_z² - 1 = 0. Trường hợp nghiêng thuần theo trục dọc cho kết quả tương tự. Dấu của cả ba số hạng vì thế nhất quán với quy ước góc ở Mã nguồn 4.2 — phép kiểm chứng này là một phép thử đơn vị tự nhiên cho dấu, nên thực hiện lại mỗi khi đổi hướng lắp cảm biến.
- Độ nhạy với sai số góc. Nếu góc ước lượng lệch δ so với góc thật, hình chiếu của trọng trường lên phương thẳng đứng sai là cosδ, nên a_z^(E) ≈ -δ²/2. Sai số là bậc hai theo δ: với δ = 1°, sai số chỉ 1,5 × 10⁻⁴ g, tức khoảng 0,15 cm/s² — nhỏ hơn khoảng hai mươi lăm lần so với σₐ = 4 cm/s² của bộ lọc độ cao. Ước lượng độ cao vì thế gần như không nhạy với sai số nhỏ của ước lượng góc.

## 4.3 Ước lượng độ cao — bộ lọc Kalman hai trạng thái

Véc-tơ trạng thái x = [z, ż]ᵀ, mô hình gia tốc là đầu vào điều khiển:

F = [1, Tₛ; 0, 1], G = [Tₛ²/2; Tₛ], H = [1, 0]

Q = GGᵀ σₐ², R = σ_z²

Tham số: σₐ = 4 cm/s², σ_z = 30 cm. Chu trình đầy đủ mỗi bước:

x⁻ = Fx⁺ + Gu, P⁻ = FP⁺Fᵀ + Q

S = HP⁻Hᵀ + R, K = P⁻Hᵀ S⁻¹

x⁺ = x⁻ + K(z^(meas) - Hx⁻), P⁺ = (I - KH)P⁻

Mã nguồn 4.4 — Khởi tạo bộ lọc Kalman độ cao (altitude_kf.ino, dòng 76–93)

76 │ void alt_kf_init() {

77 │ Fz = {1, DT_CTRL,

78 │ 0, 1};

79 │ Gz = {0.5f * DT_CTRL * DT_CTRL,

80 │ DT_CTRL};

81 │ Hz = {1, 0};

82 │ Iz = {1, 0,

83 │ 0, 1};

84 │ Qz = Gz * ~Gz * KF_SIGMA_ACC_CMS2 * KF_SIGMA_ACC_CMS2;

85 │ Rz = {KF_SIGMA_BARO_CM * KF_SIGMA_BARO_CM};

86 │ Pz = {0, 0,

87 │ 0, 0};

88 │ Sz = {0,

89 │ 0};

90 │

91 │ kf_alt_cm = 0.0f;

92 │ kf_climb_cms = 0.0f;

93 │ }

Phân tích.

- Dòng 77–81. Ba ma trận mô hình đúng như phương trình ở trên, viết theo cú pháp danh sách khởi tạo của thư viện BasicLinearAlgebra.
- Dòng 84. Q = GGᵀσₐ² là mô hình gia tốc hằng từng đoạn: giả định nhiễu gia tốc giữ nguyên trong mỗi chu kỳ và độc lập giữa các chu kỳ. Ma trận có hạng 1 — nhiễu vị trí và nhiễu vận tốc tương quan hoàn toàn, vì cả hai sinh ra từ cùng một nguồn. Ba phần tử phân biệt có giá trị 6,4×10⁻¹¹, 6,4×10^(-8) và 6,4×10^(-5).
- Dòng 85. R = σ_z² = 900 cm². So với nhiễu RMS 11 cm mà Bosch công bố cho đúng cấu hình cảm biến này (Bảng 10), σ_z lớn hơn khoảng 2,7 lần. Phần chênh phản ánh nhiễu áp suất động do luồng khí cánh quạt và chuyển động thân máy — thành phần không có mặt trong phép đo tĩnh của nhà sản xuất. Chọn σ_z bằng nhiễu tĩnh sẽ làm bộ lọc tin áp kế quá mức khi bay.
- Dòng 86–89. P₀ = 0 và x₀ = 0. Khởi tạo hiệp phương sai bằng không là tuyên bố trạng thái ban đầu được biết chính xác. Tuyên bố này đúng theo cấu tạo: độ cao là độ cao tương đối, bằng không tại mốc đo lúc khởi động (§3.3), và phương tiện đứng yên. Hệ quả: độ lợi xuất phát từ không và tăng dần theo Q, không có giai đoạn độ lợi lớn như bộ lọc góc ở §4.1.

Mã nguồn 4.5 — Một bước lọc Kalman độ cao (altitude_kf.ino, dòng 96–123)

96 │ // Gọi MỖI vòng điều khiển.

97 │ // alt_meas_m : độ cao baro, đơn vị MÉT (hàm tự đổi sang cm)

98 │ // acc_earth_z_g : gia tốc thẳng đứng đã trừ trọng lực, đơn vị g

99 │ void alt_kf_update(float alt_meas_m, float acc_earth_z_g) {

100 │ Acczz = {acc_earth_z_g * 981.0f}; // g -> cm/s^2

101 │

102 │ Sz = Fz * Sz + Gz * Acczz; // dự đoán trạng thái

103 │ Pz = Fz * Pz * ~Fz + Qz; // dự đoán hiệp phương sai

104 │

105 │ Lz = Hz * Pz * ~Hz + Rz; // hiệp phương sai phần dư

106 │

107 │ // Độ lợi Kalman: K = P·H'·L⁻¹

108 │ // Bản virex v14 viết Invert(Lz), nhưng đó là cú pháp của BasicLinearAlgebra

109 │ // 3.x. Từ bản 4.x, Invert() đảo ma trận TẠI CHỖ và trả về bool, nên viết như

110 │ // cũ sẽ không biên dịch được. Lz là ma trận 1x1 nên nghịch đảo của nó chính

111 │ // là nghịch đảo số học - viết thẳng vừa đúng, vừa không phụ thuộc phiên bản

112 │ // thư viện, lại nhanh hơn.

113 │ float Lz_scalar = Lz(0, 0);

114 │ if (Lz_scalar < 1e-6f) return; // chặn chia cho 0

115 │ Kz = Pz * ~Hz * (1.0f / Lz_scalar);

116 │

117 │ Mz = {alt_meas_m * 100.0f}; // m -> cm

118 │ Sz = Sz + Kz * (Mz - Hz * Sz); // hiệu chỉnh theo phép đo

119 │ Pz = (Iz - Kz * Hz) * Pz;

120 │

121 │ kf_alt_cm = Sz(0, 0);

122 │ kf_climb_cms = Sz(1, 0);

123 │ }

Phân tích.

- Dòng 100 và 117 — hai phép đổi đơn vị. Gia tốc đổi từ g sang cm/s² (nhân 981), độ cao áp kế đổi từ m sang cm (nhân 100). Cả hai đặt ngay tại biên vào của hàm, và chú thích ở dòng 97–98 ghi rõ đơn vị của tham số. Đây đúng là vị trí mà quy ước đơn vị trong định danh (§0.3) nhằm bảo vệ: thiếu phép nhân 100 ở dòng 117, bộ lọc so sánh độ cao tính bằng mét với trạng thái tính bằng xen-ti-mét và kéo ước lượng về một giá trị nhỏ hơn thực tế một trăm lần — không có lỗi biên dịch hay lỗi thời gian chạy nào báo hiệu.
- Dòng 102–103. Bước dự đoán; toán tử ~ là chuyển vị trong thư viện.
- Dòng 105. Hiệp phương sai phần dư — ký hiệu S ở phương trình trên, Lz trong mã.
- Dòng 113–115 — phép nghịch đảo. S là ma trận 1×1, nên nghịch đảo của nó là nghịch đảo số học. Mã nguồn khai thác điều này thay vì gọi hàm nghịch đảo ma trận tổng quát. Ngoài lợi ích tốc độ, cách viết này độc lập với phiên bản thư viện: BasicLinearAlgebra phiên bản 3.x cung cấp Invert() trả về ma trận, còn từ 4.x hàm cùng tên nghịch đảo tại chỗ và trả về kiểu logic — mã viết theo cú pháp cũ không biên dịch được trên bản mới. Chốt chặn ở dòng 114 không bao giờ kích hoạt trong vận hành vì S ≥ R = 900; nó là rào phòng thủ thuần tuý.
- Dòng 118. Bước hiệu chỉnh theo phần dư đo.
- Dòng 119 — dạng cập nhật hiệp phương sai. Mã dùng dạng rút gọn P⁺ = (I - KH)P⁻. Dạng này tương đương đại số với dạng Joseph (I-KH)P⁻(I-KH)ᵀ + KRKᵀ khi K là độ lợi tối ưu, nhưng kém bền về số học: sai số làm tròn có thể dần phá tính đối xứng và xác định dương của P [8]. Với ma trận 2×2, độ lợi cỡ 10⁻³ và thời gian chạy một chuyến bay, sai lệch tích luỹ không đáng kể; dạng Joseph là lựa chọn an toàn hơn khi tăng số trạng thái hoặc kéo dài thời gian vận hành liên tục.

Nghiệm dừng. Chỉ số bám (tracking index) của bộ lọc α–β tương đương [5]:

Λ = (σₐ Tₛ²)/(σ_z) = (4 · (0,002)²)/30 ≈ 5,33×10⁻⁷

r = (4 + Λ - √(8Λ + Λ²))/4 ≈ 0,999484

α = 1 - r² ≈ 1,03×10⁻³, β = 2(1-r)² ≈ 5,33×10⁻⁷

Hằng số thời gian của thành phần vị trí:

τ_z = Tₛ/α ≈ (0,002)/(1,03×10⁻³) ≈ 1,94 s

Ước lượng độ cao bám theo áp kế với hằng số thời gian khoảng hai giây; trong khung ngắn hơn, vận tốc thẳng đứng do tích phân gia tốc chi phối.

## 4.4 Ràng buộc nhịp giữa dự đoán và hiệu chỉnh

Đây là điểm thiết kế dễ bị hiểu sai nhất trong toàn hệ và được ghi chú tường minh ở đầu tệp altitude_kf.ino.

Bộ lọc chạy cả bước dự đoán lẫn bước hiệu chỉnh ở mỗi chu kỳ 500 Hz, kể cả khi áp kế chưa sinh mẫu mới — tức cùng một giá trị đo được nạp lại nhiều lần. Hàm baro_fetch_shared() (control_task.ino, dòng 207–212) luôn trao cho bộ lọc giá trị mới nhất hiện có, không phân biệt mới hay cũ.

Xét theo lý thuyết ước lượng thuần tuý, đây là sai: nạp lại một phép đo như phép đo độc lập làm bộ lọc đánh giá quá cao lượng thông tin nhận được. Tuy nhiên bộ tham số (σₐ, σ_z) được xác định cùng với nhịp hiệu chỉnh này. Với α ≈ 10⁻³, mỗi bước hiệu chỉnh đơn lẻ gần như không dịch chuyển ước lượng; hiệu quả kéo về chỉ hình thành nhờ được áp dụng 500 lần mỗi giây.

Thực nghiệm đã xác nhận: khi chuyển sang cổng hiệu chỉnh theo cờ dữ liệu mới (khoảng 50 Hz) mà giữ nguyên tham số, hệ mất chín phần mười số bước hiệu chỉnh trong khi độ lợi vẫn ở mức cũ. Thành phần kéo về gần như biến mất và ước lượng vận tốc thẳng đứng suy biến thành tích phân gia tốc thuần, trôi không giới hạn.

Kết luận về tính đúng đắn. Cặp (cấu trúc bộ lọc, bộ tham số) là một chỉnh thể; không được thay đổi riêng một thành phần. Muốn chuyển sang sơ đồ hiệu chỉnh theo sự kiện, phải tăng σₐ tương ứng — bậc độ lớn khoảng √(10) khi giảm mười lần số nhịp — và thẩm định lại bằng bay thử.

# Chương 5. Luật điều khiển

## 5.1 Cấu trúc phân tầng

Cấu trúc PID xếp tầng tham khảo từ tài liệu của Carbon Aeronautics [10]. Với trục dọc (roll) — trục ngang (pitch) hoàn toàn tương tự:

φ^(sp) —[Tầng 2: P]→ P_angle_roll —[Tầng 1: PID]→ PID_roll —[mixer]→ ESC

Với trục thẳng đứng ở chế độ giữ độ cao:

ż^(sp) —[Tầng 1: PID]→ PID_vel_z ga = ESC_IDLE + PID_vel_z

Nguyên tắc phân tầng: đầu ra của tầng ngoài là giá trị mong muốn của tầng trong, và giới hạn đầu ra tầng ngoài chính là giới hạn đầu vào tầng trong. Điều này bảo đảm tầng trong không bao giờ nhận giá trị mong muốn nằm ngoài khả năng theo dõi.

Trục — tầng | Khối | Đầu ra | kp | ki | kd | Chặn tích phân | Chặn đầu ra
Nghiêng — Tầng 2: góc roll, pitch | P | P_angle_roll, P_angle_pitch | 10,0 | 0 | 0 | — | 400 °/s
Nghiêng — Tầng 1: vận tốc góc roll, pitch | PID | PID_roll, PID_pitch | 0,5 | 1,4 | 0,03 | 200 | 400
Quay — Tầng 1: vận tốc góc yaw | PID | PID_yaw | 1,0 | 10,0 | 0 | 100 | 100
Thẳng đứng — Tầng 1: vận tốc thẳng đứng | PID | PID_vel_z | 3,0 | 15,0 | 0 | 700 | khâu P ±200

Tầng góc dùng chung hàm pid_step() với ki = kd = 0, nên về mặt toán học là khối P thuần; hằng chặn tích phân khai báo cho tầng này trong mã không có hiệu lực. Hai khối vận tốc góc yaw và vận tốc thẳng đứng giữ nguyên đường vi phân trong mã, với kd = 0 ở bộ tham số hiện tại.

Tầng góc chỉ dùng khâu tỉ lệ. Lựa chọn này nhất quán với thực hành trong ArduPilot (AC_AttitudeControl dùng AC_P) và PX4 [9]: sai số tích luỹ của vòng góc được xử lý bởi khâu tích phân của vòng vận tốc góc, thêm tích phân ở cả hai tầng dễ gây tương tác động học không mong muốn.

Ba chế độ bay là ba cách tổ hợp cùng một bộ khối:

Mã nguồn 5.1 — Ba chế độ bay như ba tổ hợp khối điều khiển (control_task.ino, dòng 176–198)

176 │ // ANGLE: cần gạt quy định góc nghiêng, thả cần thì drone tự về bằng.

177 │ void mode_angle() {

178 │ u_throttle = rc_ch[CH_THROTTLE] * 0.8f;

179 │ u_roll = pid_rate_roll (rate_roll_dps, pid_tilt_roll (roll_deg, roll_sp_deg));

180 │ u_pitch = pid_rate_pitch(rate_pitch_dps, pid_tilt_pitch(pitch_deg, pitch_sp_deg));

181 │ u_yaw = pid_rate_yaw (rate_yaw_dps, yaw_rate_sp_dps);

182 │ }

183 │

184 │ // ALT HOLD: cần ga quy định TỐC ĐỘ lên xuống. Cần ga ở giữa = giữ độ cao.

185 │ void mode_alt_hold() {

186 │ u_throttle = ESC_IDLE + pid_climb(alt_kf_get_climb_cms(), climb_sp_cms);

187 │ u_roll = pid_rate_roll (rate_roll_dps, pid_tilt_roll (roll_deg, roll_sp_deg));

188 │ u_pitch = pid_rate_pitch(rate_pitch_dps, pid_tilt_pitch(pitch_deg, pitch_sp_deg));

189 │ u_yaw = pid_rate_yaw (rate_yaw_dps, yaw_rate_sp_dps);

190 │ }

191 │

192 │ // FAILSAFE: giữ thăng bằng và hạ đều cho tới khi chạm đất rồi tự tắt máy.

193 │ void mode_failsafe() {

194 │ u_throttle = ESC_IDLE + pid_climb(alt_kf_get_climb_cms(), FAILSAFE_DESCENT_CMS);

195 │ u_roll = pid_rate_roll (rate_roll_dps, pid_tilt_roll (roll_deg, 0));

196 │ u_pitch = pid_rate_pitch(rate_pitch_dps, pid_tilt_pitch(pitch_deg, 0));

197 │ u_yaw = pid_rate_yaw (rate_yaw_dps, 0);

198 │ }

Phân tích.

- Nguồn ga và nguồn giá trị mong muốn. ANGLE lấy ga trực tiếp từ cần gạt (dòng 178); ALT HOLD và FAILSAFE lấy ga từ khối vận tốc thẳng đứng (dòng 186, 194). FAILSAFE thay mọi giá trị mong muốn đến từ tay điều khiển bằng hằng số (dòng 194–197). Ngoài hai khác biệt đó, ba chế độ dùng chung toàn bộ khối.
- Dòng 179 — xếp tầng bằng lời gọi lồng. Biểu thức pid_rate_roll(rate, pid_tilt_roll(angle, sp)) hiện thực trực tiếp sơ đồ: đầu ra khối P tầng góc là đối số giá trị mong muốn của khối PID tầng vận tốc góc. Thứ tự tính ở đây được ngôn ngữ bảo đảm — đối số phải được tính xong trước khi thân hàm ngoài thực thi — khác với trường hợp hai toán hạng ngang hàng ở Mã nguồn 2.1.
- Dòng 181 — trục quay không có tầng góc. Giá trị mong muốn từ cần gạt đi thẳng vào tầng vận tốc góc yaw. Đây là hệ quả của hạn chế L1: không có nguồn tin nào về hướng tuyệt đối để khép vòng góc hướng.
- Dòng 178 — hệ số 0,8. Xem §6.1.
- Chuyển chế độ không có chuyển tiếp mềm. Khi chuyển từ ANGLE sang ALT HOLD giữa không trung, ga nhảy từ throttle sang ESC_IDLE + PID_vel_z, trong đó khâu tích phân của khối vận tốc thẳng đứng mang giá trị còn lại từ lần dùng trước — hoặc bằng không nếu đây là lần đầu. Vì ga treo máy nằm gần như toàn bộ ở khâu tích phân (§5.4), phương tiện hụt độ cao cho tới khi khâu này tích luỹ lại đủ. Cơ chế chuyển tiếp không va đập (bumpless transfer) — khởi tạo khâu tích phân sao cho ga liên tục tại thời điểm chuyển — không được hiện thực. Ghi nhận là L13.

## 5.2 Rời rạc hoá

Mọi khối điều khiển, trừ khối vận tốc thẳng đứng, dùng chung một hàm:

Mã nguồn 5.2 — Khối PID rời rạc dùng chung (pid.ino, dòng 50–67)

50 │ // PID rời rạc, tích phân theo quy tắc hình thang, vi phân theo sai phân lùi.

51 │ float pid_step(PidState &st, float error, float kp, float ki, float kd,

52 │ float i_limit, float u_limit) {

53 │ float p_term = kp * error;

54 │

55 │ st.integral += ki * (error + st.prev_error) * DT_CTRL / 2.0f;

56 │ if (st.integral > i_limit) st.integral = i_limit;

57 │ else if (st.integral < -i_limit) st.integral = -i_limit;

58 │

59 │ float d_term = kd * (error - st.prev_error) / DT_CTRL;

60 │

61 │ float u = p_term + st.integral + d_term;

62 │ if (u > u_limit) u = u_limit;

63 │ else if (u < -u_limit) u = -u_limit;

64 │

65 │ st.prev_error = error;

66 │ return u;

67 │ }

Hàm hiện thực bốn phương trình, với e0 là sai số của lần gọi liền trước:

P = kp · e

I = I_prev + ki · ((e + e0) Tₛ)/2, -I_max ≤ I ≤ I_max

D = kd · (e - e0)/Tₛ

PID = P + I + D, -out_max ≤ PID ≤ out_max

Dòng | Biểu thức trong mã | Đại lượng
53 | p_term = kp * error | P
55 | st.integral += ki * (error + st.prev_error) * DT_CTRL / 2.0f | I
56–57 | kẹp st.integral trong ±i_limit | I_max
59 | d_term = kd * (error - st.prev_error) / DT_CTRL | D
61–63 | tổng và kẹp trong ±u_limit | PID, out_max
65 | st.prev_error = error | e0 ← e

Phân tích.

- Dòng 55 — tích phân hình thang. Tích phân dùng quy tắc hình thang thay vì tổng Riemann trái. Với tín hiệu biến thiên chậm so với Tₛ, sai số tích phân giảm từ bậc O(Tₛ) xuống O(Tₛ²).
- Thứ tự hai phép kẹp. Tích phân được kẹp ngay sau khi cộng dồn (dòng 56–57); tổng được kẹp sau cùng (dòng 62–63). Phép kẹp tổng không phản hồi về khâu tích phân: khi đầu ra đã bão hoà, tích phân vẫn tiếp tục tích luỹ cho tới I_max — cơ chế chống bão hoà được bàn ở §5.3.
- Dòng 59 — vi phân trên sai số. Khâu vi phân lấy sai phân trên sai số, không phải trên đại lượng đo. Hệ quả là mỗi lần giá trị mong muốn thay đổi bậc thang, khâu D sinh xung lớn (derivative kick). Ở bậc này ảnh hưởng bị giới hạn bởi hai yếu tố: giá trị mong muốn đã qua bộ lọc bậc nhất ở §7.3 nên không có bước nhảy thật sự, và kd = 0,03 tương đối nhỏ. Với hệ số D lớn hơn, nên chuyển sang lấy vi phân trên đại lượng đo. Không có bộ lọc thông thấp trên khâu D — khác biệt so với AC_PID của ArduPilot (tham số FLTD) và là hạn chế L3.
- Dòng 65 — cập nhật e0. Hàm không có điểm thoát sớm, nên mọi lần gọi đều đi qua dòng này và e0 luôn là sai số của lần gọi liền trước. Vì các khối chạy ở mọi chu kỳ kể cả khi chưa arm (Mã nguồn 8.1 không chặn bước điều khiển), e0 luôn tươi; lần arm đầu tiên không sinh xung vi phân từ một giá trị e0 cũ.
- Đóng gói trạng thái. Trạng thái của mỗi khối nằm trong một cấu trúc PidState (tệp types.h) truyền theo tham chiếu. Hàm vì thế thuần tuý theo tham số, và cùng một hàm phục vụ năm khối điều khiển mà không có biến toàn cục riêng cho từng khối.

## 5.3 Chống bão hoà tích phân

Cơ chế là kẹp biên độ tuyệt đối: |I| ≤ I_max sau mỗi lần cộng dồn. Đây là phương pháp đơn giản nhất trong họ chống windup, không phải phương pháp tốt nhất — nó không phân biệt trường hợp đầu ra đang bão hoà với trường hợp tích phân đang được kéo về không.

Bổ sung hai cơ chế xả:

- pid_reset_all() đặt mọi tích phân về không ở mỗi chu kỳ chưa arm.
- pid_bleed_integrators() nhân tích phân của năm khối nghiêng và quay với hệ số 0,9 mỗi chu kỳ khi throttle nhỏ hơn 830 ở chế độ ANGLE — tương ứng cần ga dưới khoảng 1038 µs, tức 830/0,8. Hằng số thời gian xả là τ = -Tₛ/ln 0,9 ≈ 19 ms. Mục đích: khi phương tiện còn trên mặt đất và bị giữ nghiêng, tích phân không tích luỹ để rồi phóng ra lúc cất cánh. Khâu tích phân của khối vận tốc thẳng đứng không bị xả, vì nó mang ga treo máy.

## 5.4 Vòng vận tốc thẳng đứng

Mã nguồn 5.3 — Khối PID của vận tốc thẳng đứng (pid.ino, dòng 69–85)

69 │ // Riêng trục thẳng đứng: khâu tích phân không cho âm vì nó gánh phần ga treo

70 │ // máy, và khâu tỉ lệ bị chặn riêng để một cú nhiễu baro không đẩy ga vọt lên.

71 │ float pid_step_climb(PidState &st, float error, float kp, float ki, float kd,

72 │ float i_limit, float p_limit) {

73 │ float p_term = kp * error;

74 │ if (p_term > p_limit) p_term = p_limit;

75 │ else if (p_term < -p_limit) p_term = -p_limit;

76 │

77 │ st.integral += ki * (error + st.prev_error) * DT_CTRL / 2.0f;

78 │ if (st.integral > i_limit) st.integral = i_limit;

79 │ else if (st.integral < 0) st.integral = 0;

80 │

81 │ float d_term = kd * (error - st.prev_error) / DT_CTRL;

82 │

83 │ st.prev_error = error;

84 │ return p_term + st.integral + d_term;

85 │ }

Khối này có ba khác biệt so với Mã nguồn 5.2, cả ba đều có căn cứ vật lý:

Khâu tỉ lệ bị chặn riêng ở ±200 (dòng 73–75), trước khi cộng. Ước lượng vận tốc thẳng đứng chịu ảnh hưởng nhiễu áp kế. Không chặn riêng khâu P thì một xung nhiễu áp suất sẽ truyền thẳng thành xung ga. Chặn tại khâu P giữ nguyên khả năng của khâu I trong việc gánh ga treo máy.

Khâu tích phân bị chặn một phía, 0 ≤ I ≤ I_max (dòng 78–79). Ở trạng thái treo ổn định, e = 0 nên P = D = 0, và toàn bộ ga treo máy nằm ở khâu tích phân: I_treo = ga_treo - ESC_IDLE. Đại lượng này luôn dương. Cho phép nó âm là cho phép bộ điều khiển đề xuất lực đẩy âm, vô nghĩa với cơ cấu chấp hành một chiều quay. Cận trên I_max = 700 cho phép ga từ riêng khâu tích phân lên tới 1500 đơn vị đếm, tương đương khoảng 1873 µs — đủ dư cho khung có tỉ số lực đẩy trên trọng lượng thấp.

Không kẹp tổng (dòng 84). Đầu ra được cộng vào ESC_IDLE rồi mới đưa qua khâu giới hạn cuối cùng của từng động cơ (§6.2).

## 5.5 Ma trận phân phối

Bốn đầu ra động cơ là tổ hợp tuyến tính của ga và ba đầu ra khối vận tốc góc:

m₁ = throttle - PID_roll - PID_pitch - PID_yaw

m₂ = throttle + PID_roll + PID_pitch - PID_yaw

m₃ = throttle + PID_roll - PID_pitch + PID_yaw

m₄ = throttle - PID_roll + PID_pitch + PID_yaw

Viết gọn dưới dạng ma trận phân phối, mỗi hàng một động cơ, mỗi cột một trục:

Động cơ | Vị trí | Cột roll | Cột pitch | Cột yaw
1 | trước – phải | −1 | −1 | −1
2 | sau – trái | +1 | +1 | −1
3 | trước – trái | +1 | −1 | +1
4 | sau – phải | −1 | +1 | +1

Vị trí động cơ lấy theo sơ đồ đấu nối kèm theo. Đọc ma trận theo cột:

- Cột roll (-,+,+,-): PID_roll dương tăng lực đẩy hai động cơ bên trái (2, 3) và giảm hai động cơ bên phải (1, 4).
- Cột pitch (-,+,-,+): PID_pitch dương tăng lực đẩy phía sau (2, 4) và giảm phía trước (1, 3).
- Cột yaw (-,-,+,+): mã hoá chiều quay. Động cơ 1 và 2 — một đường chéo — quay cùng chiều; động cơ 3 và 4 — đường chéo còn lại — quay chiều ngược lại. Tăng một cặp, giảm cặp kia làm mô-men phản lực quanh trục đứng mất cân bằng mà không đổi tổng lực đẩy. Ở trạng thái cân bằng, mô-men phản lực của hai cặp triệt tiêu nhau.

Ba cột đều có tổng bằng không, nên trực giao với véc-tơ đồng pha 1. Không gian bốn chiều của lực đẩy vì vậy được tách thành một chiều lực đẩy tổng — do throttle điều khiển — và ba chiều mô-men do ba đầu ra PID điều khiển. Bốn tín hiệu tương ứng một – một với bốn chiều độc lập, và thay đổi một tín hiệu không làm nhiễu ba chiều còn lại, chừng nào không động cơ nào bị bão hoà.

Mã nguồn 5.4 — Bộ trộn động cơ và xuất xung (control_task.ino, dòng 156–164)

156 │ // ---------- 5. Mixer quad X và xuất ESC ----------

157 │ esc_1 = u_throttle - u_roll - u_pitch - u_yaw;

158 │ esc_2 = u_throttle + u_roll + u_pitch - u_yaw;

159 │ esc_3 = u_throttle + u_roll - u_pitch + u_yaw;

160 │ esc_4 = u_throttle - u_roll + u_pitch + u_yaw;

161 │ esc_clamp(esc_lim_lo, esc_lim_hi);

162 │

163 │ if (!armed) { esc_1 = esc_2 = esc_3 = esc_4 = ESC_IDLE; }

164 │ esc_write(esc_1, esc_2, esc_3, esc_4);

Phân tích.

- Dòng 157–160. Hiện thực ma trận theo từng hàng. Biểu thức trộn kiểu int với float được tính bằng số thực rồi cắt phần thập phân khi gán vào biến int — sai số tối đa một đơn vị đếm, tức 1,25 µs, không đáng kể.
- Dòng 161 — hệ quả của phép kẹp độc lập. Mỗi động cơ được kẹp riêng rẽ. Khi một động cơ chạm cận trên trong lúc động cơ đối diện chưa chạm, chênh lệch lực đẩy giữa hai bên bị cắt bớt: mô-men thực tế nhỏ hơn mô-men yêu cầu, và phần bị cắt không đồng đều giữa ba trục. Hệ mất một phần thẩm quyền điều khiển tư thế đúng lúc cần nhất — ga cao, cơ động mạnh. Các bộ trộn công nghiệp, ví dụ AP_MotorsMatrix của ArduPilot [9], xử lý bằng cách ưu tiên mô-men: dịch đồng thời cả bốn giá trị để giữ nguyên chênh lệch, chấp nhận hy sinh lực đẩy tổng. Ghi nhận là L12.
- Dòng 163 — ghi đè khi chưa arm. Xem §6.2.

# Chương 6. Cơ cấu chấp hành

## 6.1 Ánh xạ tín hiệu

Ngoại vi LEDC của ESP32 phát xung với tần số 391 Hz và độ phân giải 11 bit. Chu kỳ và bước lượng tử:

T_pwm = 1/391 = 2557,5 µs, Δ_pwm = (2557,5)/(2^(11)) = 1,2488 µs/đơn vị

Mã nguồn 6.1 — Cấu hình bốn kênh xung ESC (esc_output.ino, dòng 30–31 và 39–43)

30 │ #define ESC_PWM_FREQ_HZ 391

31 │ #define ESC_PWM_BITS 11

⋮

39 │ void esc_init() {

40 │ ledcSetup(ESC_LEDC_CH_1, ESC_PWM_FREQ_HZ, ESC_PWM_BITS); ledcAttachPin(PIN_ESC_1, ESC_LEDC_CH_1);

41 │ ledcSetup(ESC_LEDC_CH_2, ESC_PWM_FREQ_HZ, ESC_PWM_BITS); ledcAttachPin(PIN_ESC_2, ESC_LEDC_CH_2);

42 │ ledcSetup(ESC_LEDC_CH_3, ESC_PWM_FREQ_HZ, ESC_PWM_BITS); ledcAttachPin(PIN_ESC_3, ESC_LEDC_CH_3);

43 │ ledcSetup(ESC_LEDC_CH_4, ESC_PWM_FREQ_HZ, ESC_PWM_BITS); ledcAttachPin(PIN_ESC_4, ESC_LEDC_CH_4);

Kiểm chứng hai đầu dải làm việc:

Giá trị đếm | Độ rộng xung | Ý nghĩa
800 | 800 × 1,2488 = 999,0 µs | ngưỡng dưới chuẩn ESC
1600 | 1600 × 1,2488 = 1998,1 µs | ngưỡng trên chuẩn ESC

Cặp tham số (391 Hz, 11 bit) được chọn sao cho ánh xạ từ giá trị đếm sang micro giây gần như tỉ lệ 1 : 1,25, đưa dải làm việc 800–1600 trùng khớp chuẩn PWM 1000–2000 µs với sai lệch dưới 0,1%. Độ phân giải lực đẩy là 1,25 µs trên dải 1000 µs, tức khoảng 800 mức — dư so với yêu cầu.

Hệ số 0,8 ở chế độ ANGLE. Mã nguồn 5.1, dòng 178, nhân ga từ cần gạt với 0,8. Hệ số này chính là nghịch đảo của bước lượng tử 1,25 µs: độ rộng xung cần ga x µs được ánh xạ thành 0,8x đơn vị đếm, tức 0,8x × 1,2488 ≈ 0,999x µs ở đầu ra. Nói cách khác, xung ra ESC lặp lại đúng độ rộng xung của cần ga, sai lệch 0,1%; toàn bộ phép đổi đơn vị gói trong một hằng số.

## 6.2 Giới hạn và trạng thái an toàn

Trạng thái | Cận dưới | Cận trên
Chưa arm | 800 | 800
Đã arm | 900 | 1600

Cận dưới 900 khi đã arm bảo đảm động cơ không dừng hẳn giữa không trung. Động cơ dừng rồi khởi động lại có độ trễ đáng kể và không đồng đều giữa bốn nhánh, gây mất điều khiển tạm thời.

Ngoài khâu kẹp, còn một chốt chặn tường minh: khi armed sai, bốn giá trị bị ghi đè bằng ESC_IDLE bất kể kết quả tính toán phía trước (Mã nguồn 5.4, dòng 163). Đây là dư thừa có chủ ý — một tầng bảo vệ không phụ thuộc vào tính đúng đắn của các cận.

# Chương 7. Giao diện điều khiển từ xa

## 7.1 Lớp vật lý

SBUS là giao thức nối tiếp không đồng bộ, 100 000 baud, khung 8E2 (8 bit dữ liệu, 1 bit chẵn lẻ chẵn, 2 bit dừng), mức logic đảo.

UART của ESP32 đảo tín hiệu bằng phần cứng, kích hoạt bằng tham số thứ năm của begin() (rc_sbus.ino, dòng 52). Nhờ đó không cần mạch đảo ngoài — khác với nhiều nền tảng phải bổ sung transistor.

Thời lượng một khung:

t_frame = (25 byte × 12 bit)/100000 = 3,0 ms

## 7.2 Giải mã và kiểm tra tính toàn vẹn

Mười sáu kênh mã hoá liên tục 11 bit mỗi kênh, không theo biên byte.

Khung được chấp nhận khi thoả đồng thời ba điều kiện: độ dài đúng 25 byte, byte đầu bằng 0x0F, byte cuối bằng 0x00. Sai bất kỳ điều kiện nào thì bỏ toàn bộ khung. Đây không phải kiểm tra mã dư vòng nên không phát hiện được mọi lỗi bit, nhưng đủ để loại các khung lệch đồng bộ — dạng lỗi phổ biến nhất trên đường truyền nối tiếp.

Mã nguồn 7.1 — Tách mười sáu kênh 11 bit (rc_sbus.ino, dòng 82–98)

82 │ // Tách 16 kênh, mỗi kênh 11 bit, xếp liên tục không theo biên byte

83 │ static void sbus_decode_channels() {

84 │ int bit_ptr = 0;

85 │ int byte_ptr = 1;

86 │ sbus_raw_ch[0] = sbus_frame[23];

87 │

88 │ for (int chan = 1; chan <= 16; chan++) {

89 │ sbus_raw_ch[chan] = 0;

90 │ for (int bit = 0; bit < 11; bit++) {

91 │ sbus_raw_ch[chan] |= ((sbus_frame[byte_ptr] >> bit_ptr) & 1) << bit;

92 │ if (++bit_ptr > 7) {

93 │ bit_ptr = 0;

94 │ byte_ptr++;

95 │ }

96 │ }

97 │ }

98 │ }

Phân tích.

- Cấu trúc bit. 16 kênh × 11 bit = 176 bit = 22 byte tải. Trong mỗi byte, bit thấp đi trước; kênh sau nối tiếp ngay sau bit cuối của kênh trước.
- Dòng 91. Bit thứ bit_ptr của byte byte_ptr được đặt vào vị trí bit của kênh hiện hành. Hai con trỏ tiến đồng bộ (dòng 92–95); vòng lặp chạy đúng 176 lần, số lần lặp không phụ thuộc dữ liệu — thời gian thực thi tất định, tính chất cần có của mọi đoạn mã chạy trong tác vụ định kỳ.
- Dòng 86 — byte cờ. Byte 23 của khung được lưu vào phần tử 0 nhưng không được sử dụng ở bất kỳ đâu trong mã nguồn. Theo mô tả giao thức được các bộ giải mã mã nguồn mở thống nhất [9], bit 2 của byte này báo mất khung và bit 3 báo bộ thu đã vào chế độ an toàn (failsafe). Hệ quả được phân tích ở §7.4.

Ánh xạ tuyến tính từ giá trị thô sang dải quy ước:

u_µs = 990 + (v_raw - 173)·(2010 - 990)/(1811 - 173)

## 7.3 Định hình lệnh

Lệnh cần gạt qua bộ lọc thông thấp bậc nhất, a = 0,05 ở 500 Hz:

yₖ = (1-a)y_k-1 + a xₖ

Hằng số thời gian và tần số cắt tương đương:

τ = (Tₛ(1-a))/a ≈ 38 ms, f_c = 1/(2πτ) ≈ 4,2 Hz

Băng thông này nằm trên dải thao tác của người lái (dưới 2 Hz) và dưới tần số đặc trưng của rung cơ khí, nên lọc được nhiễu lượng tử hoá của bộ thu mà không làm chậm cảm giác điều khiển.

## 7.4 Phát hiện mất liên lạc

Mã nguồn 7.2 — Cập nhật kênh và phát hiện mất liên lạc (rc_sbus.ino, dòng 101–112)

101 │ // Trả về true khi vẫn còn sóng, false khi mất sóng.

102 │ bool rc_update() {

103 │ if (sbus_read_frame()) {

104 │ sbus_decode_channels();

105 │ for (int i = 1; i <= 16; i++) {

106 │ sbus_ch_us[i] = map(sbus_raw_ch[i], SBUS_RAW_MIN, SBUS_RAW_MAX,

107 │ SBUS_OUT_MIN, SBUS_OUT_MAX);

108 │ }

109 │ sbus_last_frame_ms = millis();

110 │ }

111 │ return (millis() - sbus_last_frame_ms <= SBUS_TIMEOUT_MS);

112 │ }

Phân tích.

- Dòng 106–107. Ánh xạ tuyến tính dùng hàm map() số nguyên: phép chia bỏ phần dư, sai số dưới 1 µs.
- Dòng 109 và 111. Mốc thời gian chỉ cập nhật khi có khung hợp lệ. Điều kiện: quá 200 ms không nhận được khung hợp lệ thì coi là mất liên lạc. Với chu kỳ khung điển hình 7–14 ms, ngưỡng này tương đương 14–28 khung liên tiếp bị mất — đủ lớn để không kích hoạt nhầm do nhiễu ngắn hạn, đủ nhỏ để phản ứng kịp. Phép trừ không dấu ở dòng 111 cho kết quả đúng cả khi millis() tràn.
- Tiền đề ngầm của cơ chế. Toàn bộ việc phát hiện mất liên lạc dựa vào việc khung SBUS ngừng đến. Tiền đề này chỉ đúng khi bộ thu được cấu hình ngừng phát khi mất sóng — chế độ thường gọi là no pulses. Nhiều bộ thu mặc định tiếp tục phát khung khi mất sóng: hoặc giữ nguyên giá trị kênh cuối cùng, hoặc phát bộ giá trị an toàn đặt trước, đồng thời bật bit failsafe trong byte cờ. Với cấu hình như vậy, điều kiện ở dòng 111 luôn đúng, rc_ok không bao giờ về sai, và chế độ mất liên lạc ở §8.2 không kích hoạt: phương tiện tiếp tục bay theo giá trị kênh cuối cùng — có thể gồm cả công tắc arm ở nấc 2 và cần ga ở mức treo máy.

Hai cách khắc phục. (a) Cấu hình bộ thu ở chế độ ngừng phát khung khi mất sóng — không cần sửa mã, nhưng an toàn phụ thuộc vào một thiết lập nằm ngoài phần mềm. (b) Bổ sung kiểm tra bit 3 của byte cờ trong hàm giải mã, coi khung mang cờ failsafe là khung không hợp lệ — cơ chế an toàn trở nên độc lập với cấu hình bộ thu. Ghi nhận là L10.

# Chương 8. Kiến trúc an toàn

## 8.1 Máy trạng thái cho phép khởi động động cơ

Điều kiện chuyển sang trạng thái arm:

arm ⇔ (sw = 2) ∧ (sw_prev ≠ 2) ∧ (cần ga < 1050)

Ba thành phần, mỗi thành phần loại một kịch bản nguy hiểm:

- Phát hiện sườn (sw_prev ≠ 2) yêu cầu một thao tác chuyển trạng thái chủ động, không chấp nhận trạng thái tĩnh.
- Cần ga ở đáy loại trường hợp arm khi cần ga đang mở.
- Khởi tạo sw_prev = 2 bảo đảm nếu cấp nguồn trong lúc công tắc đã ở vị trí arm thì điều kiện sườn không thoả. Người dùng phải gạt công tắc ra rồi gạt lại. Không có chi tiết này, phương tiện có thể tự arm ngay khi cấp nguồn.

Mã nguồn 8.1 — Máy trạng thái arm, chế độ và mất liên lạc (control_task.ino, dòng 104–137)

104 │ // ---------- 3. Arm / disarm ----------

105 │ // Arm khi công tắc VÀO nấc 2 và cần ga đang ở dưới cùng. Dùng điều kiện

106 │ // "vào nấc 2 từ nấc bất kỳ" nên chạy đúng với cả công tắc 2 nấc lẫn 3 nấc.

107 │ if (rc_ok) {

108 │ if (rc_ch[CH_ARM] != 2) {

109 │ armed = false;

110 │ } else if (arm_sw_prev != 2 && rc_ch[CH_THROTTLE] < 1050) {

111 │ armed = true;

112 │ }

113 │ arm_sw_prev = rc_ch[CH_ARM];

114 │

115 │ if (rc_ch[CH_MODE] == 0) flight_mode = MODE_FOR_SW_0;

116 │ else if (rc_ch[CH_MODE] == 1) flight_mode = MODE_FOR_SW_1;

117 │ else flight_mode = MODE_FOR_SW_2;

118 │

119 │ } else if (armed && sensor_present.baro) {

120 │ // Mất sóng khi đang bay: tự hạ độ cao

121 │ if (rc_ok_prev) failsafe_start_ms = millis();

122 │ flight_mode = MODE_FAILSAFE;

123 │ } else {

124 │ armed = false; // mất sóng mà không có baro thì tắt máy

125 │ }

126 │

127 │ if (armed) { esc_lim_lo = ESC_MIN_ARMED; esc_lim_hi = ESC_MAX; }

128 │ else { esc_lim_lo = ESC_IDLE; esc_lim_hi = ESC_IDLE; pid_reset_all(); }

129 │

130 │ // Hạ xong thì tự disarm: ga đã đáy, gần như hết tốc độ rơi, quá 2 giây

131 │ if (!rc_ok && armed) {

132 │ if (u_throttle < ESC_MIN_ARMED + 1 &&

133 │ fabsf(alt_kf_get_climb_cms()) < 5.0f &&

134 │ (millis() - failsafe_start_ms) > 2000) {

135 │ armed = false;

136 │ }

137 │ }

Bảng chuyển trạng thái tương ứng dòng 107–125:

rc_ok | Nấc arm | Nấc chu kỳ trước | Cần ga | Kết quả
đúng | khác 2 | bất kỳ | bất kỳ | disarm ngay
đúng | 2 | khác 2 | < 1050 | arm
đúng | 2 | khác 2 | ≥ 1050 | giữ nguyên, không arm
đúng | 2 | 2 | bất kỳ | giữ nguyên
sai | — | — | — | đang arm và có áp kế: FAILSAFE; ngược lại: disarm

Phân tích.

- Dòng 113. arm_sw_prev được cập nhật sau khi xét điều kiện — thứ tự bắt buộc của phát hiện sườn.
- Dòng 121. Mốc thời điểm mất sóng chỉ được ghi ở sườn chuyển từ có sóng sang mất sóng (rc_ok_prev đúng, rc_ok sai), nên không bị ghi đè ở các chu kỳ mất sóng tiếp theo.
- Dòng 127–128. Cận xung ESC đổi theo trạng thái; khi chưa arm, mọi tích phân bị xoá ở mỗi chu kỳ.
- Dòng 108 và khiếm khuyết L9. Điều kiện "nấc arm khác 2 thì disarm ngay" là đúng về thiết kế, nhưng cũng chính là nơi khiếm khuyết ở Mã nguồn 1.4, dòng 228 biểu hiện: một lần ánh xạ kép biến nấc 2 thành 0, và dòng 109 tắt động cơ.

Ghi chú về tính tương thích. Cách phát hiện sườn "vào vị trí 2 từ vị trí bất kỳ" hoạt động đúng với cả công tắc hai nấc lẫn ba nấc. Cách đặc tả chặt hơn — đòi chuyển trực tiếp 0 → 2 — sẽ hỏng với công tắc ba nấc, vì cần gạt bắt buộc đi qua nấc giữa và ở tần số lấy mẫu 500 Hz thì nấc trung gian chắc chắn được ghi nhận.

## 8.2 Chế độ mất liên lạc

Khi mất tín hiệu trong lúc đang arm, hệ chuyển sang MODE_FAILSAFE với ba hành vi đồng thời:

1. Giá trị mong muốn của góc nghiêng và vận tốc góc yaw về không — giữ thăng bằng.
2. Giá trị mong muốn của vận tốc thẳng đứng bằng FAILSAFE_DESCENT_CMS = −60 cm/s. Đây là hạ có điều khiển: khối vận tốc thẳng đứng bám theo giá trị mong muốn, tự bù ga khi có gió hoặc khi điện áp nguồn sụt. Khác biệt căn bản với việc cắt động cơ, vốn dẫn tới rơi tự do.
3. Tự disarm khi hội đủ ba điều kiện (Mã nguồn 8.1, dòng 131–136): ga do khối vận tốc thẳng đứng tính ra không vượt ngưỡng tối thiểu khi arm (dòng 132), độ lớn vận tốc thẳng đứng ước lượng dưới 5 cm/s (dòng 133), và đã qua ít nhất 2 s kể từ thời điểm mất sóng (dòng 134). Điều kiện thời gian tính từ mốc mất sóng ghi ở dòng 121, không phải thời gian duy trì của hai điều kiện kia.

Cơ chế nhận biết chạm đất. Sau khi chạm đất, ż → 0 trong khi giá trị mong muốn vẫn là −60 cm/s, nên sai số e_vel_z = −60 cm/s được duy trì. Khâu P góp −180 — nằm trong giới hạn ±200 — còn khâu I giảm với tốc độ ki · |e| = 15 × 60 = 900 đơn vị mỗi giây cho tới 0. Ga vì thế rơi xuống dưới ngưỡng 900 trong vòng chưa đầy một giây sau khi chạm đất. Ngược lại, trong pha hạ đều, vận tốc thẳng đứng xấp xỉ 60 cm/s và ga ở mức treo máy, nên không điều kiện nào thoả: bộ ba điều kiện loại trừ việc tắt máy khi còn trên không.

Điều kiện tiên quyết. Toàn bộ quy trình chỉ kích hoạt khi sensor_present.baro đúng. Không có nguồn độ cao thì ước lượng vận tốc thẳng đứng suy biến thành tích phân gia tốc không có hiệu chỉnh, và "hạ có điều khiển" trở thành điều khiển theo số liệu không tồn tại. Trong trường hợp đó hệ cắt động cơ ngay. Ngoài ra, như đã phân tích ở §7.4, quy trình chỉ được kích hoạt khi khung SBUS thật sự ngừng đến lúc mất sóng.

Đây là ví dụ về nguyên tắc thiết kế đáng chú ý: một cơ chế an toàn phải tự kiểm tra tiền đề của chính nó, và phải suy biến về hành vi đơn giản hơn khi tiền đề không thoả — thay vì thực thi một quy trình phức tạp trên dữ liệu không đáng tin.

# Chương 9. Phân tích định lượng bổ sung

## 9.1 Ngân sách thời gian vòng điều khiển

Ngân sách 2000 µs mỗi chu kỳ. Thành phần chi phối:

Thành phần | Ước tính | Ghi chú
Hai giao dịch SPI đọc IMU | ~25 µs | 2 × 7 byte ở 10 MHz, kể cả chi phí đóng mở giao dịch
Bốn hàm sin/cos, hai atan, hai căn bậc hai | ~12 µs | số thực đơn, FPU phần cứng
Kalman hai trạng thái dạng ma trận | ~15 µs | thư viện mẫu, không cấp phát động
Sáu lời gọi khối điều khiển | ~10 µs | mỗi khối vài phép nhân cộng
Ba lần lấy/nhả mutex | ~6 µs | đường không tranh chấp
Bốn lời gọi ledcWrite | ~4 µs | ghi thanh ghi

Tổng ước tính dưới 100 µs, tức dưới 5% ngân sách. Kết luận: vòng điều khiển có biên an toàn rất lớn; nút thắt của hệ không nằm ở năng lực tính toán.

Kích thước ảnh nhị phân: 308 369 byte bộ nhớ chương trình (23% dung lượng khả dụng) và 22 988 byte bộ nhớ dữ liệu tĩnh (7%).

## 9.2 Ảnh hưởng của nhiễu rung

Giả thiết G4 bị vi phạm trong vận hành thực. Nhiễu do cánh quạt là nhiễu hẹp băng, tần số trung tâm tỉ lệ tốc độ quay:

f_rung = (n_RPM)/60 × n_cánh

Với động cơ quay 6000 v/ph và cánh hai lá, tần số cơ bản khoảng 200 Hz, cùng các hài bậc cao.

Cơ chế phòng vệ duy nhất ở bậc này là bộ lọc thông thấp bên trong ICM-20602: DLPF 5 Hz cho con quay và 10,2 Hz cho gia tốc kế. Băng thông này nằm rất xa dưới dải nhiễu rung nên suy giảm hiệu quả, nhưng đổi lại đưa vào độ trễ pha đáng kể — với xấp xỉ bậc nhất, độ trễ nhóm ở tần số thấp khoảng 1/(2π f_c) ≈ 32 ms cho con quay.

Độ trễ này là nguyên nhân chính giới hạn hệ số kd khả dụng, và qua đó giới hạn băng thông vòng điều khiển đạt được.

Đây là hạn chế cấu trúc của bậc thiết kế này, không khắc phục được bằng chỉnh tham số. Lý do nằm ở bản chất của bộ lọc thông thấp đơn: hạ tần số cắt thì suy giảm nhiễu tốt hơn nhưng độ trễ pha tăng theo; nâng tần số cắt thì ngược lại. Hai đại lượng ràng buộc nhau qua cùng một tham số, nên không tồn tại điểm làm việc thoả mãn đồng thời cả hai yêu cầu.

Nói cách khác, giới hạn ở đây không phải do chọn sai tần số cắt mà do cấu trúc lọc — muốn vượt qua thì phải thay đổi cách tách nhiễu khỏi tín hiệu hữu ích, chứ không phải điều chỉnh trong khuôn khổ hiện có.

## 9.3 Đặc tính số học

Toàn bộ tính toán điều khiển dùng số thực độ chính xác đơn, ngoại trừ đa thức bù áp kế dùng độ chính xác kép vì lý do dải động (§3.3).

Các đại lượng trạng thái nằm trong dải 10⁻³ đến 10³, cách xa hai đầu dải biểu diễn. Phần tử hiệp phương sai của bộ lọc độ cao có giá trị nhỏ nhất cỡ q_11 = (Tₛ²/2)²σₐ² ≈ 6,4×10⁻¹¹, vẫn nằm trong dải chuẩn hoá của số thực đơn (ngưỡng dưới ≈ 1,2×10⁻³⁸). Không có nguy cơ mất chuẩn hoá.

Hàm pid_step() kẹp đầu ra bằng phép so sánh. Cần lưu ý rằng phép so sánh với giá trị NaN luôn cho kết quả sai, nên NaN đi qua khâu kẹp mà không bị chặn. Ở bậc này rủi ro bằng không vì mọi hệ số PID là hằng số biên dịch. Nhận xét được ghi lại để tham chiếu khi mở rộng sang cấu hình tham số động.

# Chương 10. Hạn chế đã biết

Bảng dưới phân loại hạn chế theo bản chất của chúng, không theo cách khắc phục. Phân biệt này quan trọng: có hạn chế chỉ là chỗ chưa hoàn thiện trong khuôn khổ hiện tại, có hạn chế là sai lệch giữa hành vi thực và hành vi thiết kế, và có hạn chế là hệ quả tất yếu của tập cảm biến và cấu trúc ước lượng đã chọn — loại cuối cùng không thể xử lý bằng cách sửa mã nguồn.

# | Hạn chế | Hệ quả | Bản chất | Mức độ

L1 | Không có tham chiếu hướng tuyệt đối | Góc hướng trôi; chỉ điều khiển được vận tốc góc yaw | Ràng buộc quan sát được — không nguồn tin nào mang thông tin hướng tuyệt đối | —
L2 | Mô hình đo gia tốc kế bỏ qua gia tốc chuyển động | Ước lượng góc lệch khi cơ động kéo dài (§4.1) | Ràng buộc quan sát được — một phép đo tổng, hai ẩn số | —
L3 | Không lọc khâu vi phân | Giới hạn kd khả dụng (§5.2) | Chưa hoàn thiện; sửa được tại chỗ | Thấp
L4 | Không bù phi tuyến lực đẩy | Đáp ứng phụ thuộc mức ga | Chưa hoàn thiện; cần đặc tuyến khung máy | Thấp
L5 | Không bù sụt áp nguồn | Đáp ứng thay đổi theo mức pin | Chưa hoàn thiện; cần thêm phép đo điện áp | Thấp
L6 | Chỉ có bộ lọc thông thấp đơn chống nhiễu rung | Giới hạn băng thông vòng điều khiển (§9.2) | Ràng buộc cấu trúc — một tham số, hai yêu cầu ngược nhau | —
L7 | Không có nguồn vị trí ngang | Không giữ được vị trí | Ràng buộc quan sát được — trạng thái vị trí không quan sát được từ tập cảm biến hiện có | —
L8 | Chống bão hoà tích phân bằng kẹp biên độ đơn thuần | Kém tối ưu khi bão hoà kéo dài (§5.3) | Chưa hoàn thiện; sửa được tại chỗ | Thấp
L9 | Ánh xạ công tắc chạy lại trên dữ liệu đã ánh xạ khi không lấy được khoá (§1.3) | Công tắc arm đọc thành nấc 0, động cơ ngừng khi đang bay | Khiếm khuyết; sửa được tại chỗ | Nghiêm trọng
L10 | Không đọc cờ failsafe của khung SBUS (§7.4) | Chế độ mất liên lạc phụ thuộc cấu hình bộ thu | Khiếm khuyết; sửa tại chỗ hoặc cấu hình bộ thu | Cao
L11 | Thứ tự đánh giá khi ghép byte SPI không được ngôn ngữ bảo đảm (§2.1) | Tính đúng phụ thuộc trình biên dịch | Khiếm khuyết tiềm ẩn; sửa được tại chỗ | Thấp
L12 | Bộ trộn không ưu tiên mô-men khi bão hoà (§5.5) | Mất một phần thẩm quyền tư thế ở mức ga cao | Chưa hoàn thiện; sửa được tại chỗ | Trung bình
L13 | Không có chuyển tiếp mềm khi đổi chế độ (§5.1) | Hụt độ cao tạm thời khi chuyển sang ALT HOLD | Chưa hoàn thiện; sửa được tại chỗ | Trung bình

Bốn hạn chế L1, L2, L6, L7 thuộc loại ràng buộc, không phải khiếm khuyết. Chúng là ranh giới phạm vi có chủ đích của bậc thiết kế này. Muốn vượt qua thì phải mở rộng tập cảm biến hoặc thay đổi cấu trúc ước lượng — tức là bước sang một bài toán khác, không phải sửa lỗi trong bài toán hiện tại.

Ba hạn chế L9, L10, L11 là khiếm khuyết — sai lệch giữa hành vi thực và hành vi thiết kế. Trong đó L9 và L10 liên quan trực tiếp tới an toàn bay và cần được khắc phục trước mọi cải tiến khác; với L10, cấu hình bộ thu ở chế độ ngừng phát khung khi mất sóng là biện pháp tạm thời không cần sửa mã.

Sáu hạn chế còn lại L3, L4, L5, L8, L12, L13 nằm trong khuôn khổ hiện có và có thể khắc phục mà không thay đổi kiến trúc.

# Kết luận

Hệ thống hiện thực một bộ điều khiển bay hai chế độ trên nền tảng vi điều khiển hai nhân, với các đặc điểm kiến trúc đáng chú ý:

1. Tách biệt nghiêm ngặt giữa đường điều khiển và đường phụ trợ, được bảo đảm bằng phân bổ nhân xử lý và bằng nguyên tắc không xuất dữ liệu chẩn đoán từ vòng điều khiển.
2. Chính sách khoá không chờ, đổi độ tươi của dữ liệu lấy tính tất định về thời gian — đánh đổi đúng với hệ có ràng buộc thời gian cứng.
3. Truy cập cảm biến ở mức thanh ghi, cho phép kiểm soát các chi tiết quyết định tính đúng đắn: kiểm tra hiện diện trước khi hiệu chỉnh, cổng dữ liệu theo cờ sẵn sàng, ràng buộc định thời giữa ODR và OSR.
4. Cơ chế an toàn tự kiểm tra tiền đề, thể hiện rõ nhất ở chế độ mất liên lạc: quy trình hạ cánh có điều khiển chỉ kích hoạt khi nguồn dữ liệu độ cao còn hoạt động, ngược lại suy biến về hành vi đơn giản hơn.
5. Đồng nhất bộ tham số với cấu trúc thuật toán, minh hoạ bằng trường hợp bộ lọc Kalman độ cao (§4.4): bộ tham số chỉ có nghĩa trong ngữ cảnh nhịp chạy mà nó được xác định cùng.

Điểm 5 mang giá trị phương pháp luận vượt ra ngoài hệ thống cụ thể: nó cho thấy một thay đổi đúng về mặt lý thuyết thuần tuý vẫn có thể phá hỏng hệ thống nếu không xét tới các giả định ngầm mà bộ tham số đã mã hoá.

Việc đối chiếu từng dòng mã với mô hình lý thuyết còn cho một kết quả phương pháp luận thứ hai. Hai khiếm khuyết an toàn L9 và L10 không để lại dấu hiệu trong các chuyến bay thử thông thường: L9 chỉ biểu hiện khi tranh chấp khoá rơi đúng thời điểm, L10 phụ thuộc một thiết lập nằm ngoài phần mềm. Cả hai đều lộ ra khi đọc mã với câu hỏi "tiền đề của đoạn này là gì, và điều gì xảy ra khi tiền đề không thoả". Phân tích tĩnh vì thế không thay thế được bay thử, nhưng bổ sung đúng vào chỗ bay thử không với tới được: các nhánh hiếm và các giả định ngầm.

# Phụ lục A. Bảng tham số vận hành

Tham số | Ký hiệu mã nguồn | Giá trị | Đơn vị
Chu kỳ vòng điều khiển | DT_CTRL | 0,002 | s
Góc nghiêng tối đa | LIM_TILT_DEG | 20 | độ
Vận tốc góc yaw tối đa | LIM_YAW_RATE_DPS | 100 | °/s
Vận tốc thẳng đứng tối đa | LIM_CLIMB_RATE_CMS | 100 | cm/s
Vận tốc hạ khi mất sóng | FAILSAFE_DESCENT_CMS | −60 | cm/s
Nhiễu quá trình, KF độ cao | KF_SIGMA_ACC_CMS2 | 4,0 | cm/s²
Nhiễu đo, KF độ cao | KF_SIGMA_BARO_CM | 30,0 | cm
Nhiễu quá trình, KF góc | hằng trong hàm | 1,0 | °/s
Nhiễu đo, KF góc | hằng trong hàm | 3,0 | độ
Ngưỡng hội tụ hiệu chỉnh con quay | STABLE_LIMIT | 40 | tổng của 500 lần đọc
Thời gian chờ mất liên lạc | SBUS_TIMEOUT_MS | 200 | ms

# Phụ lục B. Cấu hình đã thẩm định bằng bay thử

Thành phần | Thông số
Khung | 5 inch
Động cơ | 2204, 2300 KV
Cánh | 5 inch
Nguồn | 3S, 2200 mAh

Bộ tham số điều khiển trong Phụ lục A được xác định cho cấu hình này. Với khung có mô-men quán tính khác đáng kể, cần xác định lại — trước hết là kp của khối vận tốc góc, tỉ lệ nghịch xấp xỉ với mô-men quán tính quanh trục tương ứng.

# Phụ lục C. Tài liệu tham chiếu

1. TDK InvenSense, ICM-20602 High Performance 6-Axis MEMS MotionTracking Device, datasheet DS-000176, phiên bản 1.1. Mục 8 (bản đồ thanh ghi); mục 9.16 và 9.19 (bộ lọc thông thấp con quay và gia tốc kế); mục 9.17, 9.18 (thang đo); mục 9.38 (PWR_MGMT_1); mục 9.43 (WHO_AM_I).
2. Bosch Sensortec, BMP388 Digital Pressure Sensor, datasheet BST-BMP388-DS001-07, phiên bản 1.7 (11/2020). Mục 3.5, Bảng 10 (cấu hình khuyến nghị theo ứng dụng); mục 3.9.1, Bảng 22 (thời gian đo điển hình và tối đa); mục 3.9.2 (công thức thời gian chuyển đổi); mục 3.10 và 3.10.1 (đọc gộp, thanh ghi bóng); mục 3.11 (bù đầu ra); mục 4.3.2 và 4.3.3 (thanh ghi ERR_REG, STATUS); mục 5.3.2 (giao thức đọc SPI); mục 9.2 và 9.3 (công thức bù nhiệt độ, áp suất).
3. Espressif Systems, ESP32 Technical Reference Manual, các chương LED PWM Controller (LEDC) và UART Controller.
4. Espressif Systems, ESP-IDF Programming Guide, phần FreeRTOS (SMP): tạo tác vụ ghim nhân và đơn vị kích thước ngăn xếp.
5. Kalata, P. R., "The Tracking Index: A Generalized Parameter for α-β and α-β-γ Target Trackers", IEEE Transactions on Aerospace and Electronic Systems, tập AES-20, số 2, 1984.
6. Liu, C. L. và Layland, J. W., "Scheduling Algorithms for Multiprogramming in a Hard-Real-Time Environment", Journal of the ACM, tập 20, số 1, 1973.
7. ISO/IEC 14882, Programming Languages — C++, mục [intro.execution] về trình tự đánh giá biểu thức.
8. Grewal, M. S. và Andrews, A. P., Kalman Filtering: Theory and Practice, Wiley — phần về độ bền số học của phép cập nhật hiệp phương sai và dạng Joseph.
9. ArduPilot, mã nguồn mở AC_PID, AC_AttitudeControl, AP_MotorsMatrix và AP_RCProtocol_SBUS — tham chiếu về cấu trúc phân tầng, bộ trộn ưu tiên mô-men và cấu trúc byte cờ của khung SBUS. Giao thức SBUS không có đặc tả công bố chính thức từ nhà sản xuất.
10. Carbon Aeronautics, tài liệu và mã nguồn tại github.com/CarbonAeronautics — nguồn tham khảo cho bộ lọc Kalman một chiều ước lượng góc và cấu trúc PID xếp tầng.
11. Pedley, M., Tilt Sensing Using a Three-Axis Accelerometer, Application Note AN3461, Freescale Semiconductor — các dạng công thức góc nghiêng theo thứ tự quay.

Tài liệu tự học — Bộ điều khiển bay KyThuatUAV FC
