KyThuatUAV/ESP32_FC/Tài liệu kèm theo/Sơ đồ/drone_lap_hoan_chinh.jpg

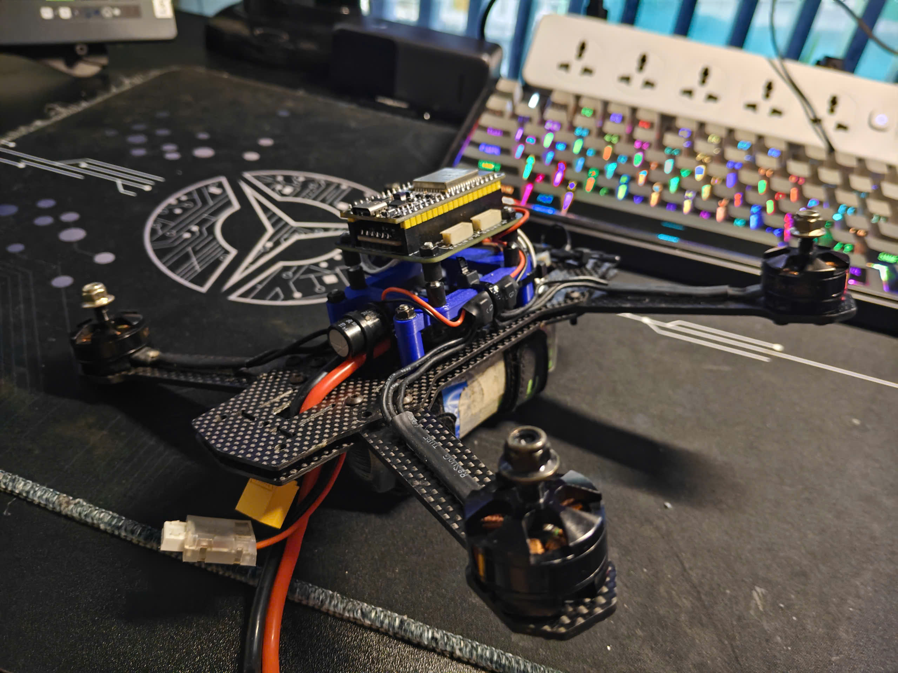
Tài liệu kèm theo/Sơ đồ/drone_lap_hoan_chinh.jpg
