KyThuatUAV/ESP32_FC/Tài liệu kèm theo/Sơ đồ/mach_gan_cam_bien.jpg

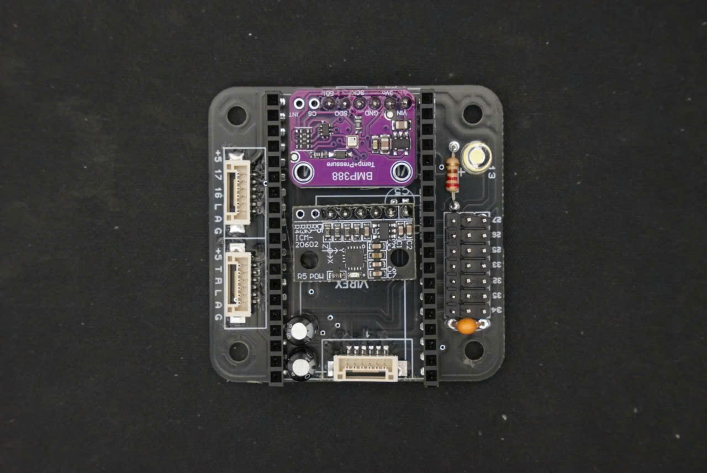
Tài liệu kèm theo/Sơ đồ/mach_gan_cam_bien.jpg
