KyThuatUAV/ESP32_FC/Tài liệu kèm theo/Sơ đồ/mach_tran.jpg

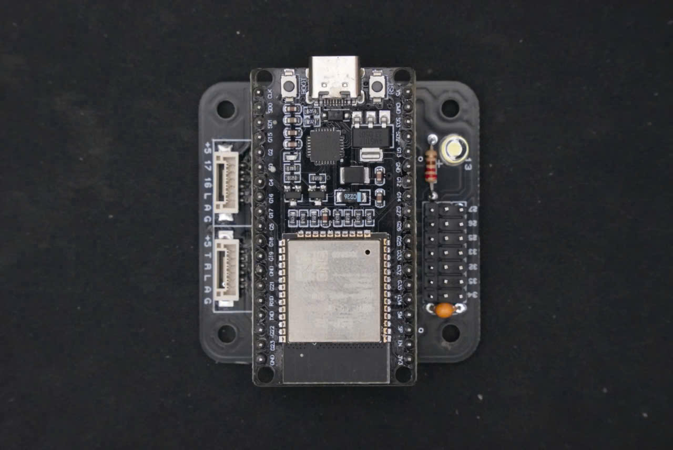
Tài liệu kèm theo/Sơ đồ/mach_tran.jpg
