KyThuatUAV/ESP32_FC/Tài liệu kèm theo/Sơ đồ/so_do_dau_noi.png

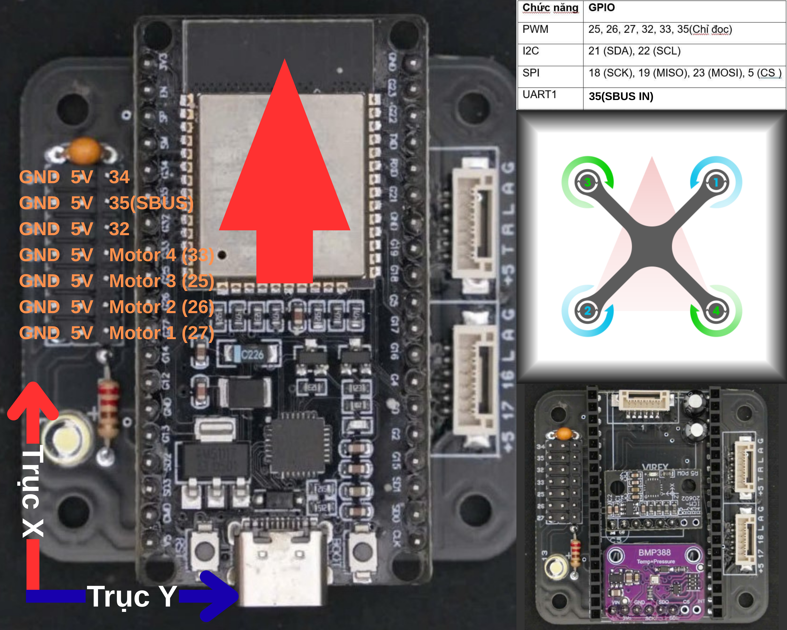
Tài liệu kèm theo/Sơ đồ/so_do_dau_noi.png
