KyThuatUAV/ESP32_FC/Tài liệu kèm theo/Sơ đồ/sodonguyenly.jpg

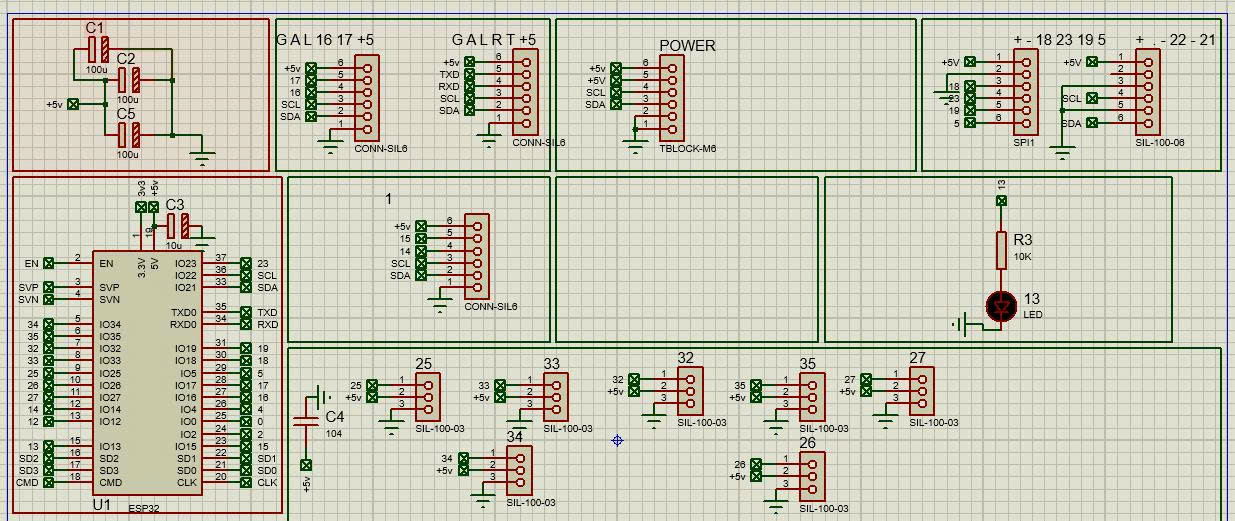
Tài liệu kèm theo/Sơ đồ/sodonguyenly.jpg
