KyThuatUAV/ESP32_FC/Tài liệu kèm theo/danh_sach_linh_kien/danh sách linh kiện.pdf

| TÊN LINH KIỆN SỐ LƯỢNG GIÁ THÀNH TIỀN GHI CHÚ LINK SẢN PHẨM LINK DỰ PHÒNG

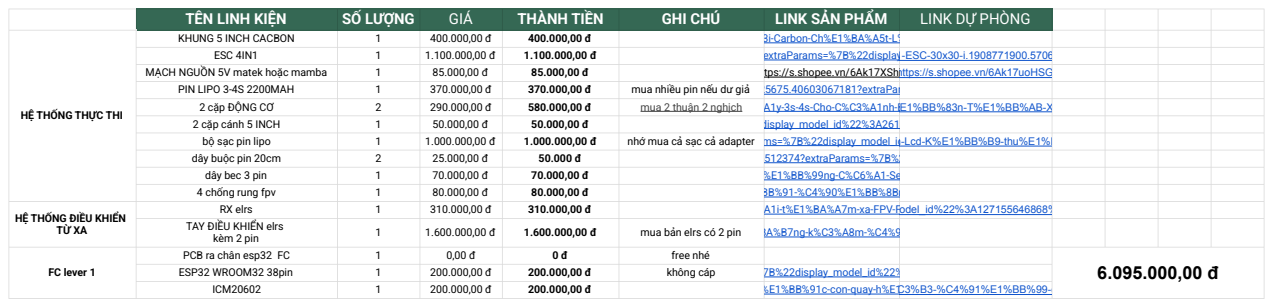
[picture p7: page 1]
2 cặp ĐỘNG CƠ; mua 2 thuận 2 nghịch; 2 cặp cánh 5 INCH; bộ sạc pin lipo; nhớ mua cả sạc cả adapter; dây buộc pin 20cm; dây bec 3 pin; 4 chống rung fpv; RX elrs; kèm 2 pin; mua bản elrs có 2 pin; FC lever 1; PCB ra chân esp32 FC; free nhé; ESP32 WROOM32 38pin; không cáp; ICM20602

HỆ THỐNG THỰC THI | KHUNG 5 INCH CACBON 1 400.000,00 đ 400.000,00 đ ESC 4IN1 1 1.100.000,00 đ 1.100.000,00 đ MẠCH NGUỒN 5V matek hoặc mamba 1 85.000,00 đ 85.000,00 đ https://s.shopee.vn/6Ak17XShiVhttps://s.shopee.vn/6Ak17uoHSG PIN LIPO 3-4S 2200MAH 1 370.000,00 đ 370.000,00 đ mua nhiều pin nếu dư giả

HỆ THỐNG ĐIỀU KHIỂN

TAY ĐIỀU KHIỂN elrs
