KyThuatUAV/ESP32_FC/(commit log)

2026-09-06 Phát hành mã nguồn bộ điều khiển bay ESP32
    Firmware kiến trúc FreeRTOS cho mạch ESP32 + ICM20602 + BMP388,
    hai chế độ bay Angle và Alt Hold, kèm tài liệu hướng dẫn đầy đủ.
    - Driver ICM20602 (SPI) và BMP388 (I2C) viết bằng thanh ghi, không dùng
    thư viện cảm biến ngoài
    - Kalman 2 trạng thái ước lượng độ cao và tốc độ thẳng đứng
    - PID xếp tầng: góc -> tốc độ góc -> lệnh động cơ
    - Tự hạ cánh có điều khiển khi mất sóng
    - Hiệu chỉnh gyro tự kiểm tra, chế độ hiệu chỉnh gia tốc kế riêng
    - Phát hành theo giấy phép GPL-3.0
2026-09-06 Thêm mục khoá học và thông tin liên hệ vào README
    Bốn bậc khoá học, hình thức đào tạo, và liên hệ Nguyễn Văn Quý.
    Ghi rõ bộ mã nguồn này dùng được đầy đủ mà không cần học khoá nào.
2026-09-06 Thêm dòng liên hệ vào header mã nguồn
    Một dòng trong khối ghi công của 9 file, để người đọc lẻ một file
    vẫn biết liên hệ ai.
2026-09-06 Thêm mục cấu hình đã bay nghiệm thu
    Ghi rõ bộ PID mặc định nghiệm trên khung 5 inch, motor 2204 2300KV,
    pin 3S. Kèm hướng chỉnh cho khung khác.
2026-09-09 Thêm tài liệu tự học, sơ đồ đấu nối và datasheet cảm biến
    - Tài liệu kèm theo/TAI_LIEU_TU_HOC.docx: phân tích hệ thống 22 trang,
    công thức chuyển sang ký hiệu Unicode để đọc thẳng trên Word.
    - Tài liệu kèm theo/Sơ đồ/: sơ đồ đấu nối, thay cho thư mục Sơ đồ lắp đặt cũ.
    Ảnh 5000x4000 đã nén lại không mất dữ liệu, 17,1 MB còn 7,8 MB.
    - Tài liệu kèm theo/datasheet/: datasheet ICM-20602 và BMP388.
    - Bỏ Huong_dan_su_dung.docx trong thư mục mã nguồn; nội dung cài đặt đã nằm
    ở Tài liệu kèm theo/HUONG_DAN_CAI_DAT.md.
    - altitude_kf.ino: sửa chú thích sigma gia tốc 1 ->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
2026-09-27 Thêm sơ đồ nguyên lý mạch
    Sơ đồ nguyên lý vẽ đầy đủ: ESP32, tụ lọc nguồn, LED báo trạng thái,
    các cổng I2C/SPI/UART và chân tín hiệu ra bốn ESC.
2026-09-27 Chỉ giữ tài liệu thuộc KyThuatUAV_FC_level_1
    - Bỏ ảnh quảng cáo khoá học trong thư mục danh sách linh kiện, và ảnh
    bàn làm việc không liên quan tới mạch.
    - Đổi tên thư mục còn lại thành danh_sach_linh_kien.
    - Đặt lại tên các ảnh theo nội dung: mach_tran, mach_gan_cam_bien,
    drone_lap_hoan_chinh, so_do_dau_noi.
2026-09-27 Đổi tên dự án thành LacWing FC
    Thư mục sketch KyThuatUAV_FC_level_1 thành LacWing_FC_level_1, kèm file
    .ino chính cùng tên để Arduino IDE mở đúng. Cập nhật tên trong header mã
    nguồn, dòng in ra Serial, README và tài liệu hướng dẫn.
    Phần ghi công và bản quyền giữ nguyên.
2026-10-16 Thêm link nhóm cộng đồng Zalo và bản tài liệu tự học mới
    - README: link nhóm Zalo đặt ngay đầu trang và trong mục Liên hệ.
    - TAI_LIEU_TU_HOC.docx: bản 49 trang, có mục lục tự động, danh mục mã
    nguồn và 21 đoạn mã trích nguyên văn kèm số dòng.
2026-10-16 Thêm mã QR nhóm cộng đồng vào README
    Ảnh QR cắt từ trang mời của Zalo, nén còn 274 KB, điểm ảnh vùng mã giữ
    nguyên. Ghi rõ tên nhóm và lưu ý mở từ TikTok thì phải quét mã.
2026-10-17 Cập nhật khoá học và thêm mục thành tích vào README
    - Bảng bốn bậc nay có đầu ra cụ thể, số buổi, học phí và chi phí linh kiện,
    khớp với trang giới thiệu khoá học.
    - Nói rõ học viên tự mua linh kiện theo danh sách công khai và được tặng PCB.
    - Thêm mục Thành tích: sáu giải UAV từ 2024 đến 2026.
2026-10-17 Nói rõ thành tích nào bay bằng LacWing
    Mục thành tích là của người đứng lớp, không phải của riêng bộ mã nguồn.
    Đánh dấu ★ hai cuộc có dùng mạch LacWing, các giải còn lại dùng nền tảng khác.
2026-10-17 Thu gọn bảng khoá học cho đọc được trên điện thoại
    Bảng cũ 5 cột, ô dài tới 105 ký tự nên bị ép vỡ trên màn hình hẹp. Rút còn
    3 cột, ô ngắn lại, số buổi gộp vào cột học phí, chi phí linh kiện đưa xuống
    dòng chữ bên dưới.
2026-10-17 Nêu rõ firmware viết 100% bằng Arduino IDE
    Thêm ngay đầu README, vì đây là rào cản lớn nhất với người mới: không phải
    cài ESP-IDF hay PlatformIO. Bỏ bớt chữ trong dòng thành tích 2026.
2026-10-17 Ghi Arduino IDE 100% vào dòng thành tích 2026
    Bỏ khối giới thiệu Arduino IDE ở đầu README, đưa ý đó vào đúng chỗ: dòng
    vô địch VAA 2026 — bay bằng mạch và mã nguồn tự phát triển 100% trên Arduino IDE.
2026-10-17 Làm rõ hai giải đáng kể nhất
    - UAV Contest lần 1 (TDT): đội duy nhất trong 9 đội bay được phần tự động,
    tám đội còn lại không hoàn thành.
    - UAV Contest lần 3 (UTE): đội duy nhất thi đấu bằng flight controller tự
    phát triển.
2026-10-17 Bổ sung bối cảnh giải UAV Contest lần 3
    Đội duy nhất trong 10 đội thi đấu bằng flight controller tự phát triển,
    chín đội còn lại dùng Pixhawk.
2026-10-17 Ghi rõ mạch nào dùng ở giải nào
    Bản ESP32 thi ở Học viện Hàng không, bản Teensy 4.1 thi ở UAV Contest lần 3,
    cả hai lập trình 100% trên Arduino IDE. Đưa vào ghi chú đầu mục để hai dòng
    trong bảng khỏi dài thêm.
2026-10-17 Viết lại đoạn khoá học cho gọn
    Gộp hai chỗ nói về linh kiện làm một, tách ý firmware thành câu riêng.
2026-10-17 Đứng tên thành tích
    Đổi tiêu đề mục thành "Thành tích của Nguyễn Văn Quý" thay vì gọi chung là
    người đứng lớp.
2026-10-17 Nói rõ mã nguồn do một tay mình viết
    Câu cũ "không phải của riêng bộ mã nguồn này" dễ bị hiểu là mình không phải
    người viết. Tách thành hai đoạn: một đoạn khẳng định quyền tác giả và dẫn tới
    mục Ghi công, một đoạn giải thích dấu ★ trong bảng.
2026-10-17 Đổi tiêu đề mục thành Thành tích của tôi Nguyễn Văn Quý
2026-10-17 Đổi tiêu đề mục thành Thành tích của mình
    Dùng cùng cách xưng hô với phần còn lại của README.
2026-10-17 Diễn đạt lại điểm khác biệt của khoá cho người mới hiểu
    Thay "tự viết firmware, không phải bấm nút trên phần mềm mua sẵn" bằng mô tả
    cụ thể việc học viên làm, và gọi thẳng tên Betaflight với ArduPilot để người
    mới có cái đối chiếu.
2026-10-23 README: đưa Á quân UAV Contest lần 2 lên đầu bảng thành tích
2026-10-23 README: bỏ chi phí linh kiện bậc 3
2026-11-08 Cập nhật danh sách linh kiện
    Bản mới cho cấu hình 5 inch dùng trong khoá bậc 1, tổng 6.095.000 đ.
    Giá đổi: khung 340k lên 400k, mạch nguồn 80k lên 85k, cánh 60k xuống 50k,
    pin 3S 400k đổi thành 3-4S 370k. PCB ra chân ESP32 vẫn 0 đồng.
