KyThuatUAV/ESP32_FC/(notices)

Notices in the files:
CODE_FC/LacWing_FC_level_1/altitude_kf.ino:
This program is free software: you can redistribute it and/or modify
it under the terms of the GNU General Public License as published by
the Free Software Foundation, either version 3 of the License, or
(at your option) any later version.
